robot-corral/mazebot/README.md

# mazebot
robot which sole purpose is to escape a maze
