robot-corral/mazebot/docs/deterministic-os.pdf

## High level design

Design is for single core MCU (at least for now).

Main | SVCall | Scheduler Timer Start

Initialize hardware

Initialize OS
Start first task / SVCall 0
Select next task to run Run task 0 | Scheduler Timer Interrupt | Select next task to run Run task 1 | Task 1 finished / SVCall 0

Select next task to run Continue running task 0

Select next task to run

... Code executing with main stack

Code executing with task 0 process stack Code executing with task 1 process stack
Figure 1 Task execution flow

### Task storage

To avoid copying a lot of data in case maximum number of tasks is largish, we are going to store tasks in a pre-allocated list. See Figure 2. List is stored with highest priority tasks 1st. Each node has index link to the next node. Index of the root of the list is going to be stored in a global variable.
We also going to store index of the currently running node and its parent. This helps us to avoid navigating the list when we want to either delete task which finished execution or move task to the back of its priority group if it was suspended.
The only loop which remains during task switching is when we need to move suspended task to the end of the group of tasks which have the same priority (not sure if it’s worth removing it, need to check how many long running tasks with the same priority am I going to have).

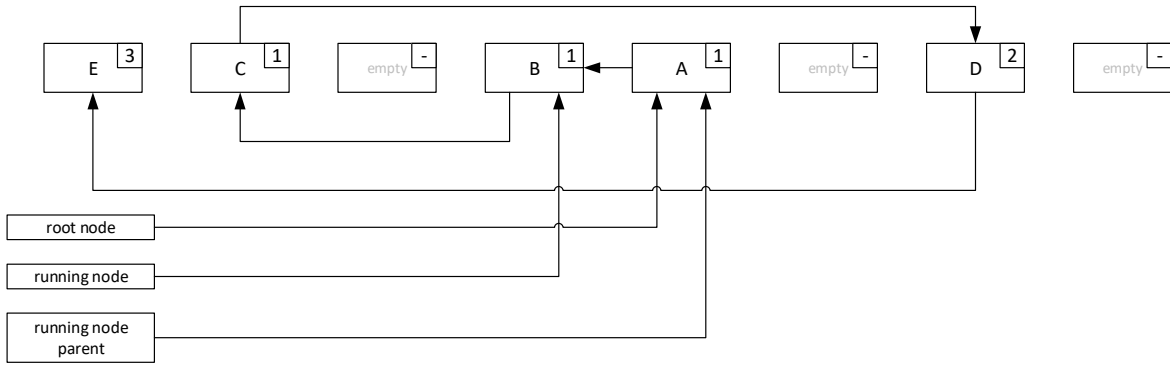
[picture p20: figure]
empty; root node; running node parent; running node

Figure 2 Task static allocation storage design
When task with the same priority we always add it to the end of the group of tasks which have the same priority. This way we maintain relative order among tasks with the same priority and task which was added first will be executed first. See Figure 3. We are adding task F which goes after task C which was the last one in the group of tasks with priority 1.
In all figures we use red color to depict what nodes and links were changed by the operation which was performed.

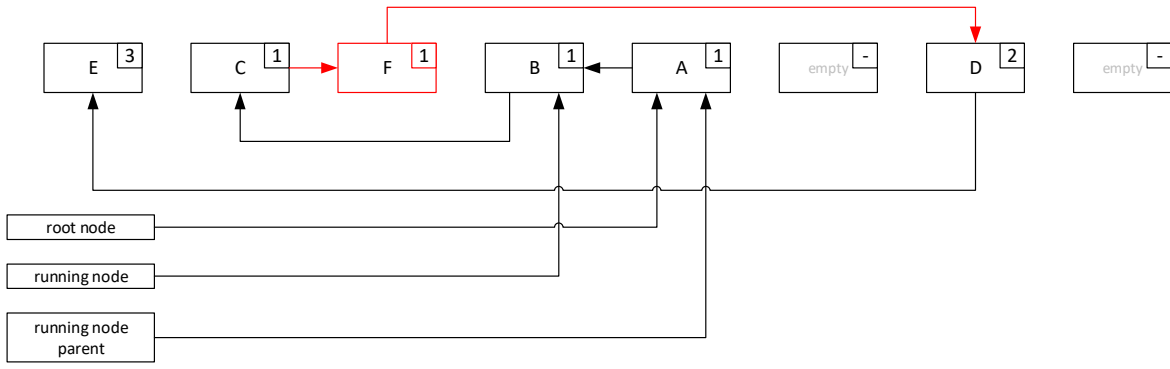
[picture p21: figure]
empty; root node; running node parent; running node

Figure 3 Adding task with the same priority as currently running task
When we add task with priority higher than currently running task, this task will go before currently running task (but after all other tasks which have higher priority). In this case we add task F with priority
0. See Figure 4.

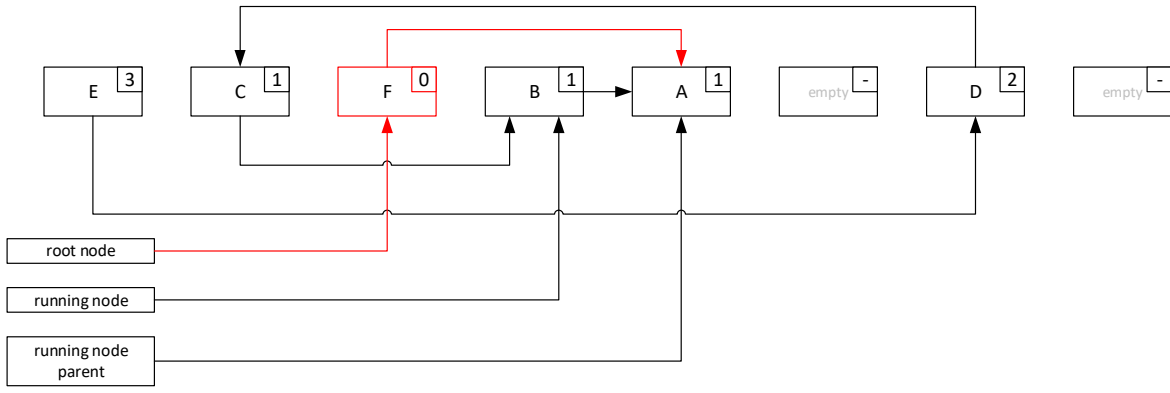
[picture p22: figure]
empty; root node; running node parent; running node

Figure 4 Adding task with highest priority
When we add task with priority lower than the current running task it will go behind it in the list. In case of the task with the lowest priority it will go to the very end of the list. In this case we add task F with priority 4. See Figure 5.

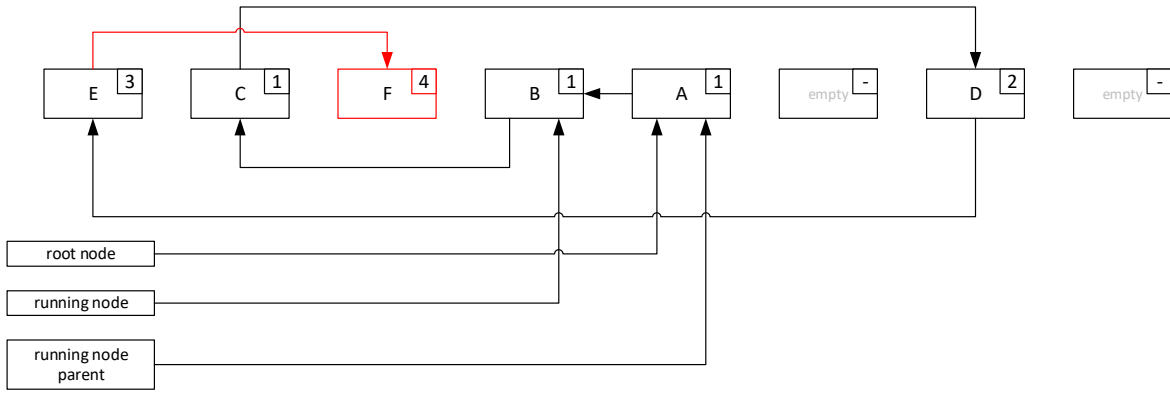
[picture p23: figure]
empty; root node; running node parent; running node

Figure 5 Adding task with lowest priority
When we need to pick next task to execute on scheduler timer call, we pick tasks with highest available priority. If currently running task has highest priority, we continue running it. If not, we suspend current task, and move it to the end of the group of tasks with the same priority (if there is more than one task with the same priority). This is done so all tasks with the same priority will execute in “parallel”. Each time slice will execute different tasks in the order they came in. For instance, if we have tasks B-A-C with priority 1 (first task in the list is the task which is being executed), then on next time slice it will be A-C-B, next one after that will be C-B-A, then B-A-C, and so on. See Figure 6.

empty

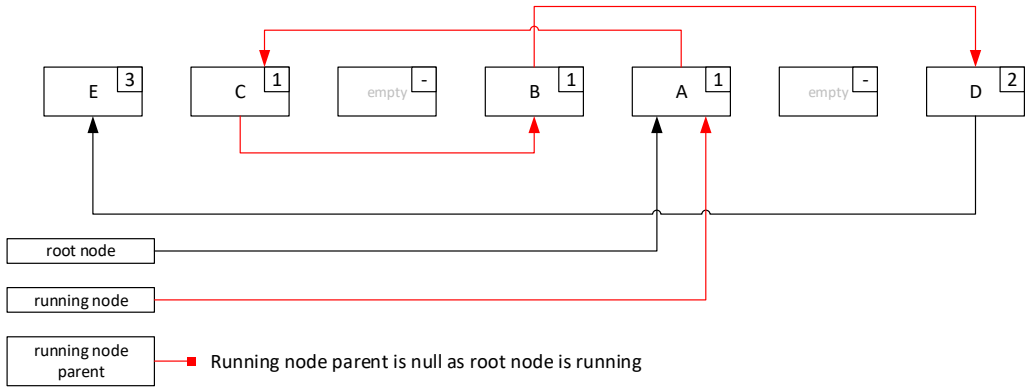
[picture p24: figure]
empty; root node; running node parent; running node

- | - | - Running node parent is null as root node is running

Figure 6 Task B was suspended, and task A was resumed

## Arm implementation details

Arm supports context switching on hardware level. There are 2 features which allow this:
- Supervisor call (SVCall) and deferred supervisor call (PendSV) interrupts
- SP_main and SP_process stacks
SVCall and PendSV allow us to avoid critical sections when doing context switching. If you have the same priority for SVCall, PendSV, and scheduling timer interrupts, then all system calls do not need any synchronization.
OS will have to issue SVCall:
- to start running task
- after task finished execution
- when we want to switch tasks on regular basis using scheduler timer
To understand how to achieve this we need to talk about ARM interrupts, stacks and registers.

### Registers

32-bit ARM processors have 16 registers:
R0 | | General / C function arguments / result values | Caller saved
R1 | | General / C function arguments / result values | Caller saved
R2 | | General / C function arguments / result values | Caller saved
R3 | | General / C function arguments / result values | Caller saved
R4 | | General | Callee saved
R5 | | General | Callee saved
R6 | | General | Callee saved
R7 | | General | Callee saved
R8 | | General | Callee saved
R9 | | General | Callee saved
R10 | | General | Callee saved
R11 | | General | Callee saved
R12 | | General | Caller saved
R13 | SP | Stack pointer | Callee saved
R14 | LR | Link register (return address) / General | Caller saved
R15 | PC | Program counter | N/A
Table 1 32-bit ARM registers
From context point of view there are 2 important groups of registers:
- caller saved – if you are going to call a function and you use any of the “caller saved” registers it is your responsibility to save them. If you do not the function you are calling is free to change their values.
- callee saved – before modifying these registers in your function you have to store their original values and restore them before you return from your function. Failure to do so can result in an undefined behavior.

### Stacks

ARM has 2 stacks MSP (SP_main) and PSP (SP_process). By default, when processor resets it uses MSP stack. When interrupt is generated interrupt handler code will also use MSP stack (even if code which was running before interrupt was using PSP stack).
You can choose which stack your code is using by changing CONTROL.SPSEL bit. Here is a sample code which sets SPSEL to 1.

# load CONTROL register to R3

MRS | R3, CONTROL
# set bit 1 (SPSEL = 1, this will make sure we use process stack instead of main stack)

ORR | R3, 0x02
# write R3 register value into CONTROL register

MSR | CONTROL, R3

To change PSP or MSP stack address you can simply modify those registers. Here is a sample code which sets PSP address to address store in R0 register

# write R0 which has process stack start address to SP (stack register)

MSR | PSP, R0

If you want to change current stack address you can simply modify SP register as you do with any other register. Here is a sample code which allocates 12 bytes on a current stack

# allocate 12 bytes on current stack

SUB | SP, 12

### Interrupts

When interrupt is generated ARM stores all caller saved registers on a stack which was active in the code which was running prior to interrupt. After that ARM sets MSP as a main stack. So, by default, all interrupt handlers will execute with MSP as their stack regardless of which stack was used prior interrupt request.

data 3
data 2
data 1
data 0

pdata 2
pdata 1
pdata 0
SP_process | SP_main

0x1000 0000

0x0FFF FFFC

0x0FFF FFF8

0x0FFF FFF4

0x1200 0000

0x11FF FFFC

0x11FF FFF8

0x00

-0x04

-0x08

-0x0C

0x00

-0x04

-0x08

active stack

Figure 7 Main and Process stacks before interrupt

pdata 2
pdata 1
pdata 0

SP_process

0x11FF FFE0

0x11FF FFDC

0x11FF FFD8

0x00

-0x04

-0x08

R0
R1
R2
R3
R12
LR
Return Address
xPSR

0x1200 0000

0x11FF FFFC

0x11FF FFF8

0x11FF FFE4

0x11FF FFF0

0x11FF FFEC

0x11FF FFE8

0x11FF FFF4 | -0x0C -0x10

-0x14

-0x18

-0x1C

-0x20

-0x24

-0x28 | data 3
data 2
data 1
data 0

SP_main

0x1000 0000

0x0FFF FFFC

0x0FFF FFF8

0x0FFF FFF4

0x00

-0x04

-0x08

-0x0C

active stack

Figure 8 Main and Process stacks after interrupt occurred but prior entering interrupt handler
If code which was executing prior exception had stack which wasn’t 8-byte aligned interrupt handler will insert dummy value before storing any registers on the stack.

### Context Switching

Given all the information about registers, stacks, and interrupts we can now describe how context switching works.
When we generate SVCall 0 at the start of OS or when current task finished executing or when scheduler timer interrupt handler is called, we have to do the following:
1) select next task which will be running (if no task found we can run dummy idle task)
2) If there was a task running before we selected next task, we need to save old task’s “callee saved” registers (R4, R5, R6, R7, R8, R9, R10, R11, PSP).
3) next task has never executed before

SP_process
new task

0x00

-0x04

-0x08

R0
R1
R2
R3
R12
LR
Return Address
0x1300 0000 | xPSR

0x12FF FFFC

0x12FF FFF8

0x12FF FFE4

0x12FF FFF0

0x12FF FFEC

0x12FF FFE8

0x12FF FFF4 | -0x0C -0x10

-0x14

-0x18

-0x1C

SP_process
idle

0x00

-0x04

-0x08

R0
R1
R2
R3
R12
LR
Return Address
0x1200 0000 | xPSR

0x11FF FFFC

0x11FF FFF8

0x11FF FFE4

0x11FF FFF0

0x11FF FFEC

0x11FF FFE8

0x11FF FFF4 | -0x0C -0x10

-0x14

-0x18

-0x1C

copy
value

store task function start address store SVC 0 instruction address store task parameter value

Figure 9 Fixing process stack for the new task (in this case old stack is from idle task but it will be similar if other task was executing before)
a. allocate space on task specific process stack for caller saved registers (8 x 4 bytes = 32 bytes)
b. set PSP to point to new task specific process stack (in Figure 9 it’s 0x12FF FFE4, processor will unwind stack and restore respective registers during interrupt exit procedure).

c. Set xPSR register value to its reset value. See “B1.5.5 Reset behavior” in ARMv7-M Architecture Reference Manual.
d. save task parameter to the top of the stack (this is where register R0 is stored)
e. save address of SVC 0 instruction on the stack where LR register is located (in our case 0x12FF FFF8). This will ensure that after task function completes it will request OS to schedule next task
f. save task function start address on the stack where Return Address is located (in our case 0x12FF FFFC). This will ensure that task function will start executing immediately after we exit from interrupt handler
4) next task was previously suspended
a. restore next task’s “callee saved registers (R4, R5, R6, R7, R8, R9, R10, R11, PSP). R0-R3, R12, LR, Return Address and xPSR are stored on the process stack and as we change PSP to point to process stack exception handler exit mechanism will restore those registers for us.
5) return from interrupt handler

### Timed task scheduler

To switch tasks, we need to call task scheduler periodically from the timer. We have two options to do this:
1. We can implement timer interrupt ourselves. This way we ensure that handler doesn’t change register values set for the task which will continue execution after we are done with the timer call. Need to investigate what will happen if timer was about to return not to process but to another lower priority interrupt.
2. We can use PendSV interrupt using the code below. PendSV is a differed interrupt which will be triggered only when execution returns from timer interrupt to the process.

“SCB->ICSR |= SCB_ICSR_PENDSVSET_Msk;”

For more information see “Use of SVCall and PendSV to avoid critical code regions” in ARMv7-M Architecture Reference Manual.
Overall option two seems to be a safer bet.
