robot-corral/mazebot/(threads)

Thread 19 (2020-01-13):

test board next to BLE wireless board. Need to check interference from BLE and if I need to put capacitors.

usaguerrilla, 2020-01-13:

usaguerrilla, 2020-01-19:
board seems to be working jut fine
need to move to use LL API instead of HAL

Closed 2020-01-19.

Thread 20 (2020-01-18):

investigate why first 2-4 communications lead to errors (client calling line sensor)

usaguerrilla, 2020-01-18:

Thread 22 (2020-01-18):

adc hardware should be reset on failure which might be related to hardware (dma, etc.)

usaguerrilla, 2020-01-18:

Thread 24 (2020-01-20):

what to do in case of error and one tx or rx completed flag gets reset and another one doesn't

usaguerrilla, 2020-01-20:

Thread 41 (2020-02-02):

position controller calibration is flaky

usaguerrilla, 2020-02-02:
should be:

1) move until 0 limiter is on
2) move right and reset position to 0 if 0 limiter fires
3) move until max limiter is on
4) move left and remember max position where max limiter fired as MAX_POSITION.
5) use (MAX_POSITION - safety) as position controller range

Closed 2020-02-03.

Thread 42 (2020-02-02):

fix potential concurrency issues in position controller (timer and limit switches have different interrupt priorities)

usaguerrilla, 2020-02-02:

Closed 2020-02-03.

Thread 44 (2020-03-03):

add command to reset wireless line sensor

usaguerrilla, 2020-03-03:

Thread 45 (2020-03-03):

add command to reset line sensor

usaguerrilla, 2020-03-03:

Thread 55 (2020-03-10):

add schematics and design pcb

usaguerrilla, 2020-03-10:
- mcu (powerful, maybe even multicore)
- imu
- left/right motor control connections
- left/right motor encoders connections
- line sensor connection
- voltage regulator
- led (good for debugging)
- mini sd card
- pins to connect logic analyzer / oscilloscope
- reset button
- start / pause button
- flush sd button
- ok / error led
- sd busy led
- st-link
- spi / uart for inter-processor communication

Thread 56 (2020-03-10):

need to minimize time between disableInterrupts / setInterruptMask

usaguerrilla, 2020-03-10:
currently too much time is spent while interrupts are disabled.
need to only disable them while updating status, changing hardware state.

Closed 2020-03-15.

Thread 61 (2020-03-13):

position controller has small error on each move

usaguerrilla, 2020-03-13:
if I move 9468 steps in one go position controller moves 118.35 mm.

If I move 9480 steps controller moves around 3 mm more than it should.

usaguerrilla, 2020-03-14:
- had a short spike on motor movement start
- disabled motor too fast at the end without allowing it to move

Closed 2020-03-14.

Thread 62 (2020-03-14):

improve timers usage

usaguerrilla, 2020-03-14:
- dma should only be used to enable slow down if we don't have constant speed movement
- timer should be used in all other cases to speed up, move at constant speed, and stat slowdown after constant speed

usaguerrilla, 2020-03-15:
not needed

usaguerrilla, 2020-03-17:
not needed again

Closed 2020-03-17.
