robot-corral/mazebot/hardware/line-sensor/line-sensor-var1a-r3.brd

## EAGLE design hardware/line-sensor/line-sensor-var1a-r3.brd (2020-03-11)

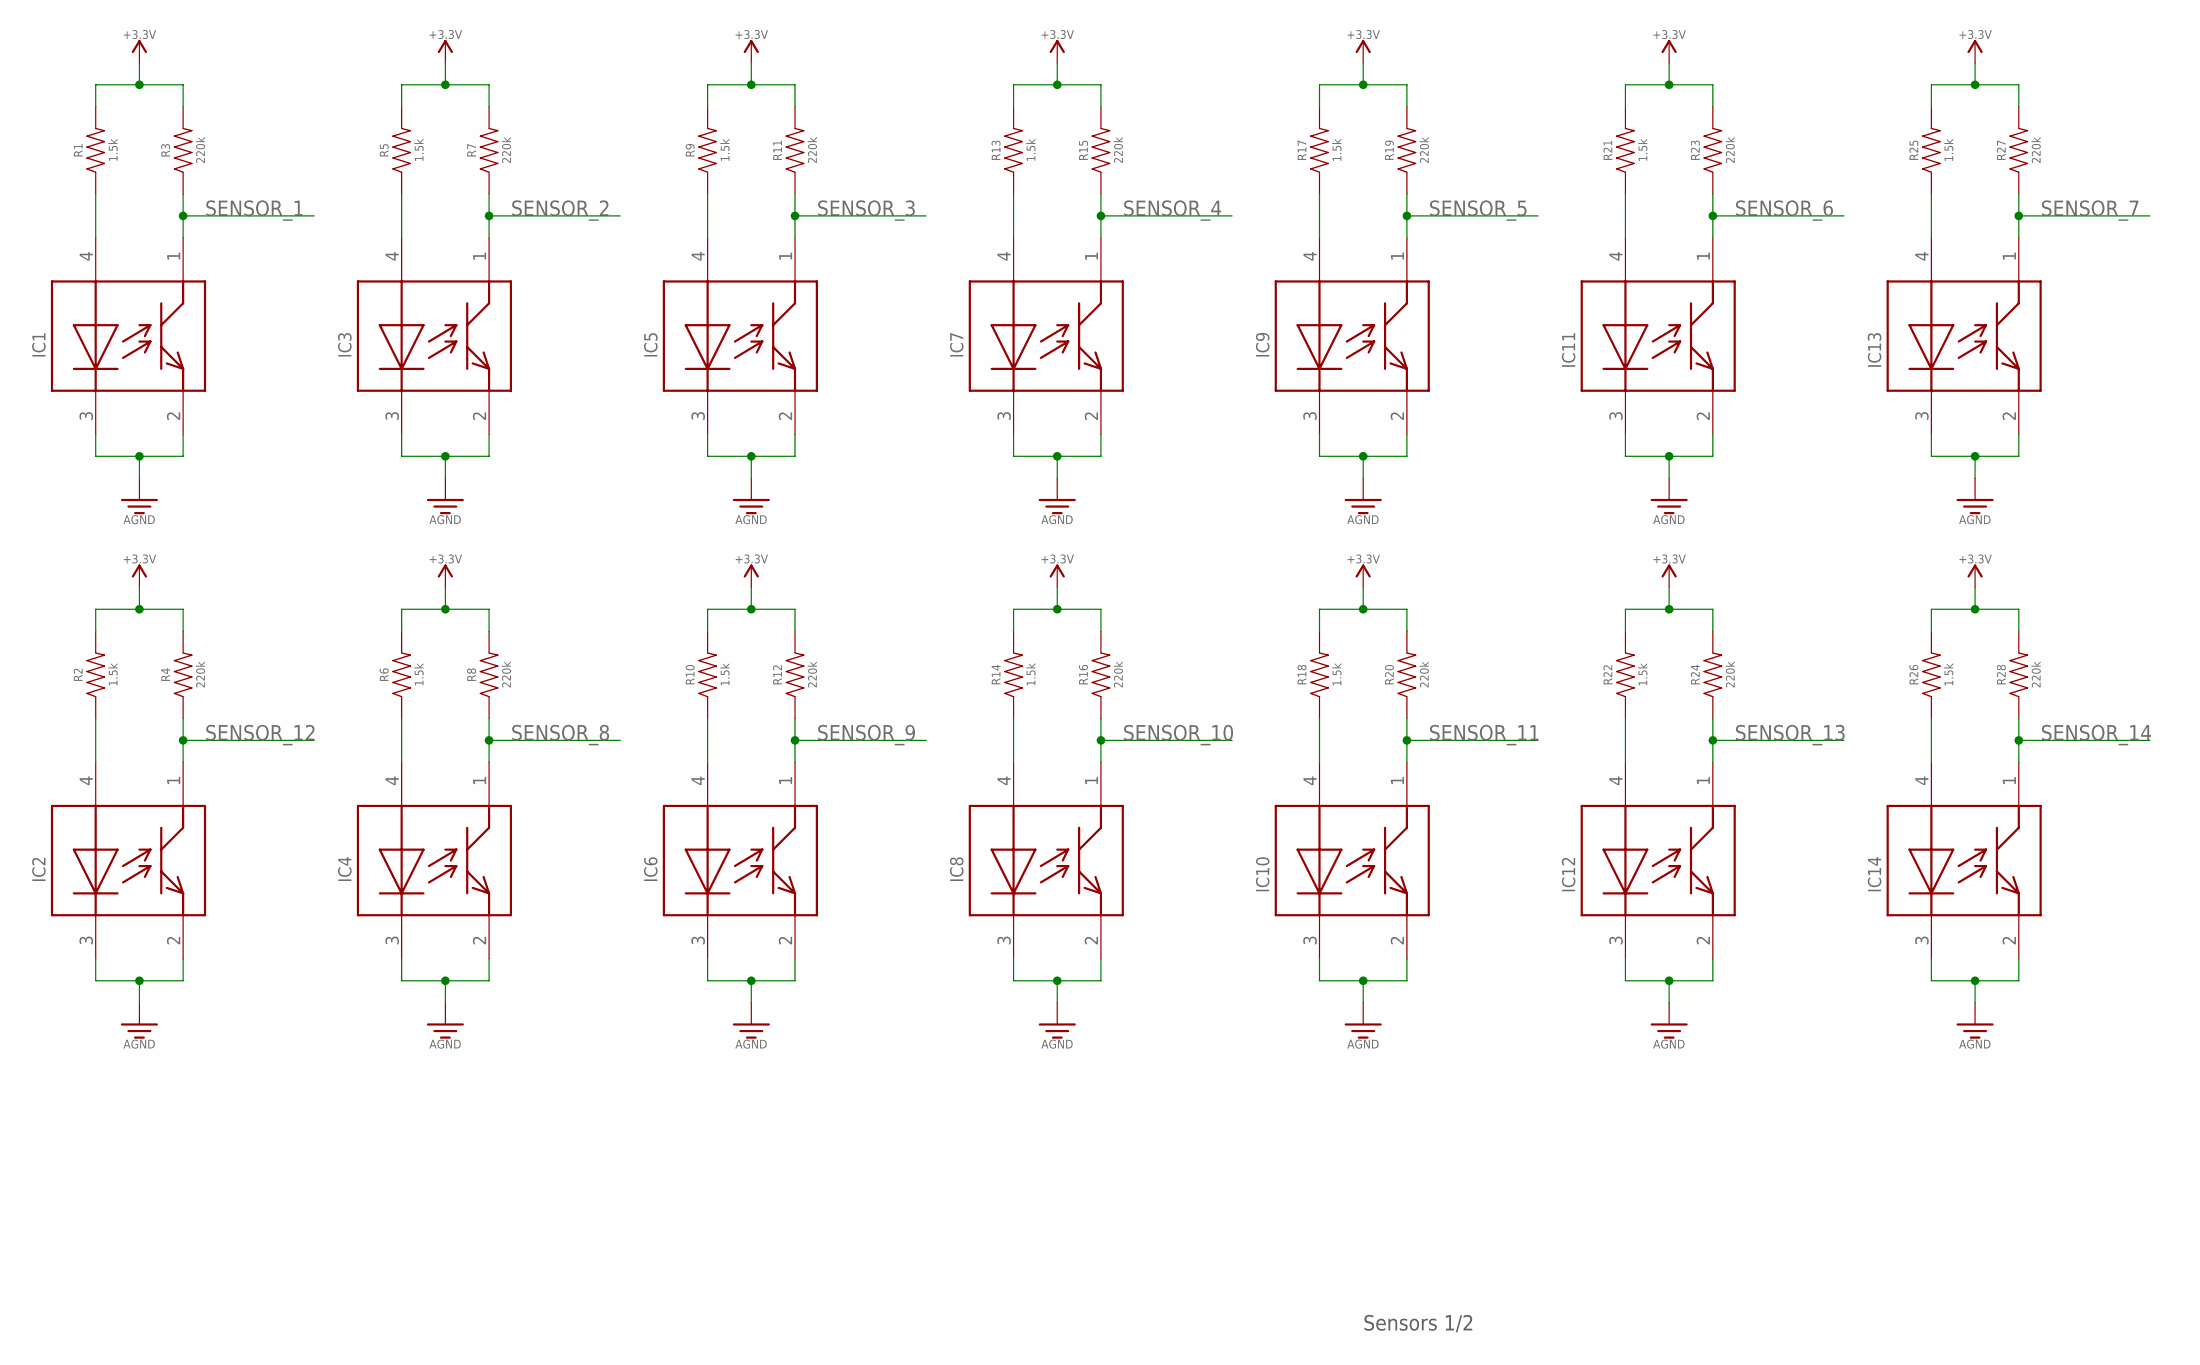
[picture p25: schematic line-sensor-var1a-r3.sch, sheet 1]

Parts:
IC1, IC2, IC3, IC4, IC5, IC6, IC7, IC8, IC9, IC10, IC11, IC12, IC13, IC14: GP2S60
R1, R2, R5, R6, R9, R10, R13, R14, R17, R18, R21, R22, R25, R26: 1.5k; RESISTOR-0603
R3, R4, R7, R8, R11, R12, R15, R16, R19, R20, R23, R24, R27, R28: 220k; RESISTOR-0603

Connections:
GND: IC1.2, IC1.3, IC2.2, IC2.3, IC3.2, IC3.3, IC4.2, IC4.3, IC5.2, IC5.3, IC6.2, IC6.3, IC7.2, IC7.3, IC8.2, IC8.3, IC9.2, IC9.3, IC10.2, IC10.3, IC11.2, IC11.3, IC12.2, IC12.3, IC13.2, IC13.3, IC14.2, IC14.3; also elsewhere on the board
unnamed: IC3.4, R5.P$1 (1)
unnamed: IC1.4, R1.P$1 (1)
unnamed: IC5.4, R9.P$1 (1)
unnamed: IC7.4, R13.P$1 (1)
unnamed: IC9.4, R17.P$1 (1)
unnamed: IC11.4, R21.P$1 (1)
unnamed: IC13.4, R25.P$1 (1)
unnamed: IC4.4, R6.P$1 (1)
unnamed: IC6.4, R10.P$1 (1)
unnamed: IC8.4, R14.P$1 (1)
unnamed: IC10.4, R18.P$1 (1)
unnamed: IC2.4, R2.P$1 (1)
unnamed: IC12.4, R22.P$1 (1)
unnamed: IC14.4, R26.P$1 (1)
SENSOR_1: IC1.1, R3.P$1 (1); also elsewhere on the board
SENSOR_2: IC3.1, R7.P$1 (1); also elsewhere on the board
SENSOR_3: IC5.1, R11.P$1 (1); also elsewhere on the board
SENSOR_4: IC7.1, R15.P$1 (1); also elsewhere on the board
SENSOR_5: IC9.1, R19.P$1 (1); also elsewhere on the board
SENSOR_6: IC11.1, R23.P$1 (1); also elsewhere on the board
SENSOR_7: IC13.1, R27.P$1 (1); also elsewhere on the board
SENSOR_8: IC4.1, R8.P$1 (1); also elsewhere on the board
SENSOR_9: IC6.1, R12.P$1 (1); also elsewhere on the board
SENSOR_10: IC8.1, R16.P$1 (1); also elsewhere on the board
SENSOR_11: IC10.1, R20.P$1 (1); also elsewhere on the board
SENSOR_12: IC2.1, R4.P$1 (1); also elsewhere on the board
SENSOR_13: IC12.1, R24.P$1 (1); also elsewhere on the board
SENSOR_14: IC14.1, R28.P$1 (1); also elsewhere on the board
VDD: R1.P$2 (2), R2.P$2 (2), R3.P$2 (2), R4.P$2 (2), R5.P$2 (2), R6.P$2 (2), R7.P$2 (2), R8.P$2 (2), R9.P$2 (2), R10.P$2 (2), R11.P$2 (2), R12.P$2 (2), R13.P$2 (2), R14.P$2 (2), R15.P$2 (2), R16.P$2 (2), R17.P$2 (2), R18.P$2 (2), R19.P$2 (2), R20.P$2 (2), R21.P$2 (2), R22.P$2 (2), R23.P$2 (2), R24.P$2 (2), R25.P$2 (2), R26.P$2 (2), R27.P$2 (2), R28.P$2 (2); also elsewhere on the board

Notes on the sheet:
Sensors 1/2

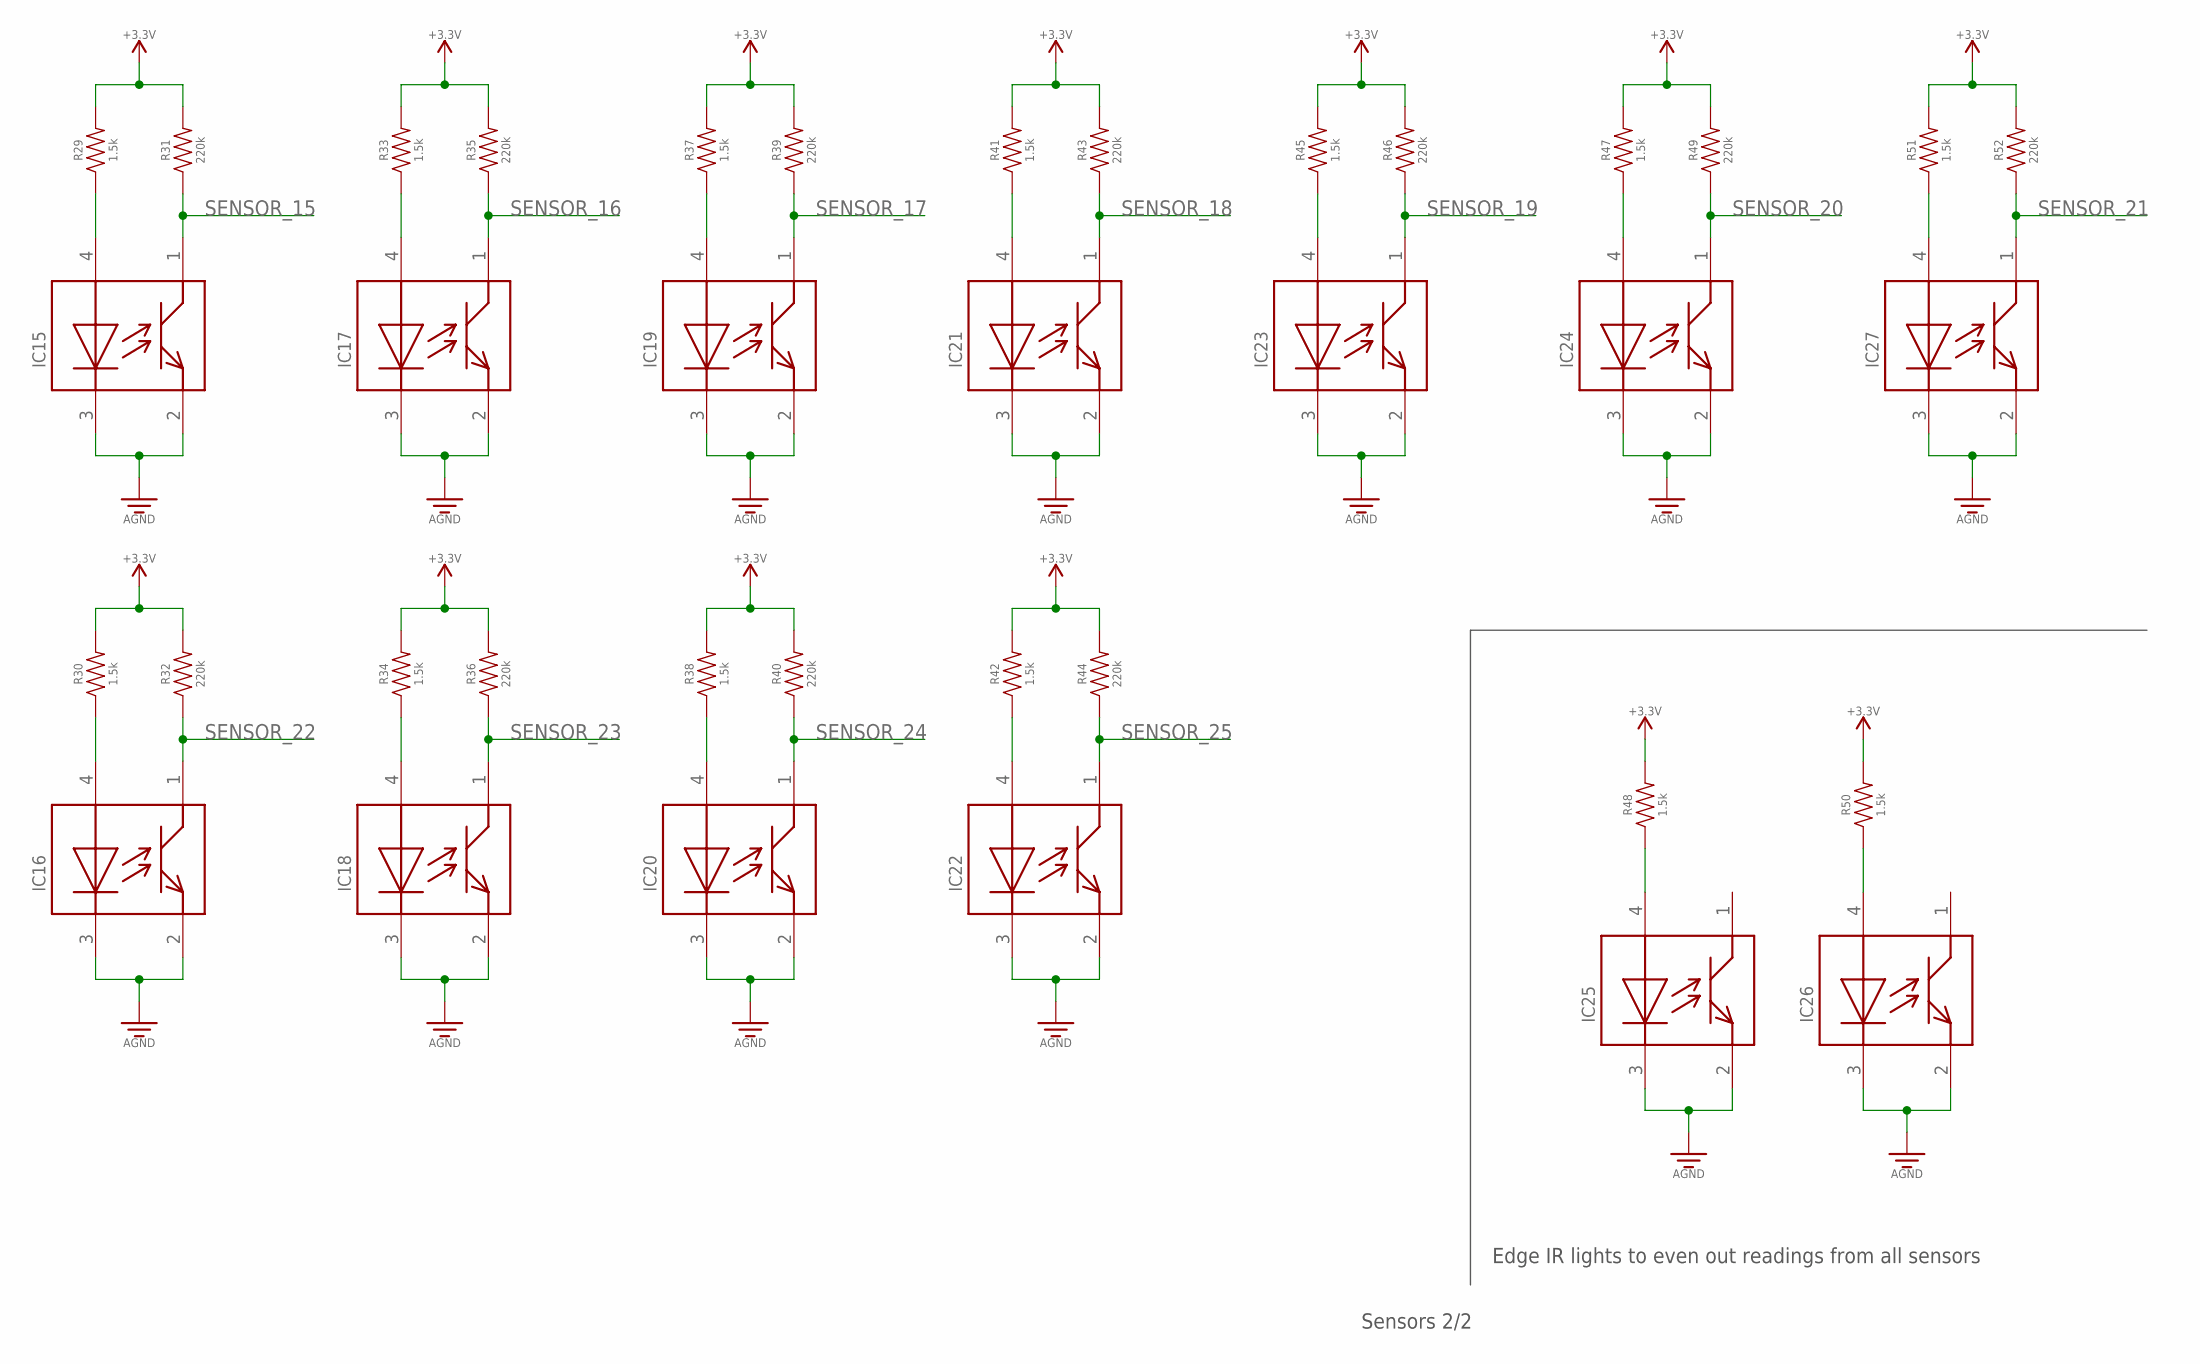
[picture p26: schematic line-sensor-var1a-r3.sch, sheet 2]

Parts:
IC15, IC16, IC17, IC18, IC19, IC20, IC21, IC22, IC23, IC24, IC25, IC26, IC27: GP2S60
R29, R30, R33, R34, R37, R38, R41, R42, R45, R47, R48, R50, R51: 1.5k; RESISTOR-0603
R31, R32, R35, R36, R39, R40, R43, R44, R46, R49, R52: 220k; RESISTOR-0603

Connections:
GND: IC15.2, IC15.3, IC16.2, IC16.3, IC17.2, IC17.3, IC18.2, IC18.3, IC19.2, IC19.3, IC20.2, IC20.3, IC21.2, IC21.3, IC22.2, IC22.3, IC23.2, IC23.3, IC24.2, IC24.3, IC25.2, IC25.3, IC26.2, IC26.3, IC27.2, IC27.3; also elsewhere on the board
unnamed: IC15.4, R29.P$1 (1)
unnamed: IC17.4, R33.P$1 (1)
unnamed: IC19.4, R37.P$1 (1)
unnamed: IC21.4, R41.P$1 (1)
unnamed: IC23.4, R45.P$1 (1)
unnamed: IC24.4, R47.P$1 (1)
unnamed: IC27.4, R51.P$1 (1)
unnamed: IC16.4, R30.P$1 (1)
unnamed: IC18.4, R34.P$1 (1)
unnamed: IC20.4, R38.P$1 (1)
unnamed: IC22.4, R42.P$1 (1)
unnamed: IC26.4, R50.P$1 (1)
unnamed: IC25.4, R48.P$1 (1)
SENSOR_15: IC15.1, R31.P$1 (1); also elsewhere on the board
SENSOR_16: IC17.1, R35.P$1 (1); also elsewhere on the board
SENSOR_17: IC19.1, R39.P$1 (1); also elsewhere on the board
SENSOR_18: IC21.1, R43.P$1 (1); also elsewhere on the board
SENSOR_19: IC23.1, R46.P$1 (1); also elsewhere on the board
SENSOR_20: IC24.1, R49.P$1 (1); also elsewhere on the board
SENSOR_21: IC27.1, R52.P$1 (1); also elsewhere on the board
SENSOR_22: IC16.1, R32.P$1 (1); also elsewhere on the board
SENSOR_23: IC18.1, R36.P$1 (1); also elsewhere on the board
SENSOR_24: IC20.1, R40.P$1 (1); also elsewhere on the board
SENSOR_25: IC22.1, R44.P$1 (1); also elsewhere on the board
VDD: R29.P$2 (2), R30.P$2 (2), R31.P$2 (2), R32.P$2 (2), R33.P$2 (2), R34.P$2 (2), R35.P$2 (2), R36.P$2 (2), R37.P$2 (2), R38.P$2 (2), R39.P$2 (2), R40.P$2 (2), R41.P$2 (2), R42.P$2 (2), R43.P$2 (2), R44.P$2 (2), R45.P$2 (2), R46.P$2 (2), R47.P$2 (2), R48.P$2 (2), R49.P$2 (2), R50.P$2 (2), R51.P$2 (2), R52.P$2 (2); also elsewhere on the board

Notes on the sheet:
Sensors 2/2
Edge IR lights to even out readings from all sensors

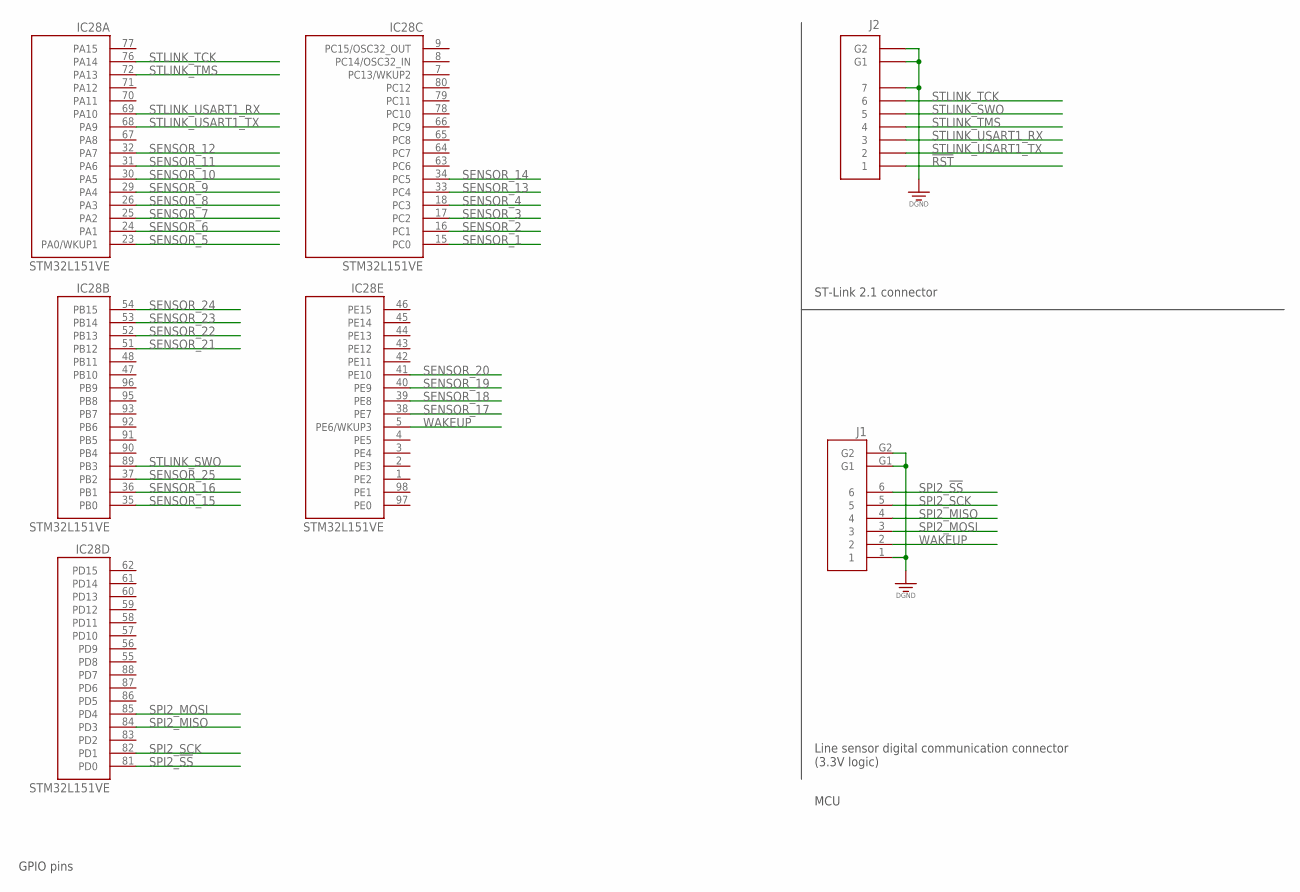
[picture p27: schematic line-sensor-var1a-r3.sch, sheet 3]

Parts:
IC28: STM32L151VE; LQFP100_14X14
J1: MOLEX-502382-06XX
J2: MOLEX-53261-0771

Connections:
!RST: J2.1; also elsewhere on the board
GND: J1.1, J1.G1, J1.G2, J2.7, J2.G1, J2.G2; also elsewhere on the board
SENSOR_1: IC28.15 (PC0); also elsewhere on the board
SENSOR_2: IC28.16 (PC1); also elsewhere on the board
SENSOR_3: IC28.17 (PC2); also elsewhere on the board
SENSOR_4: IC28.18 (PC3); also elsewhere on the board
SENSOR_5: IC28.23 (PA0/WKUP1); also elsewhere on the board
SENSOR_6: IC28.24 (PA1); also elsewhere on the board
SENSOR_7: IC28.25 (PA2); also elsewhere on the board
SENSOR_8: IC28.26 (PA3); also elsewhere on the board
SENSOR_9: IC28.29 (PA4); also elsewhere on the board
SENSOR_10: IC28.30 (PA5); also elsewhere on the board
SENSOR_11: IC28.31 (PA6); also elsewhere on the board
SENSOR_12: IC28.32 (PA7); also elsewhere on the board
SENSOR_13: IC28.33 (PC4); also elsewhere on the board
SENSOR_14: IC28.34 (PC5); also elsewhere on the board
SENSOR_15: IC28.35 (PB0); also elsewhere on the board
SENSOR_16: IC28.36 (PB1); also elsewhere on the board
SENSOR_17: IC28.38 (PE7); also elsewhere on the board
SENSOR_18: IC28.39 (PE8); also elsewhere on the board
SENSOR_19: IC28.40 (PE9); also elsewhere on the board
SENSOR_20: IC28.41 (PE10); also elsewhere on the board
SENSOR_21: IC28.51 (PB12); also elsewhere on the board
SENSOR_22: IC28.52 (PB13); also elsewhere on the board
SENSOR_23: IC28.53 (PB14); also elsewhere on the board
SENSOR_24: IC28.54 (PB15); also elsewhere on the board
SENSOR_25: IC28.37 (PB2); also elsewhere on the board
SPI2_!SS: IC28.81 (PD0), J1.6
SPI2_MISO: IC28.84 (PD3), J1.4
SPI2_MOSI: IC28.85 (PD4), J1.3
SPI2_SCK: IC28.82 (PD1), J1.5
STLINK_SWO: IC28.89 (PB3), J2.5
STLINK_TCK: IC28.76 (PA14), J2.6
STLINK_TMS: IC28.72 (PA13), J2.4
STLINK_USART1_RX: IC28.69 (PA10), J2.3
STLINK_USART1_TX: IC28.68 (PA9), J2.2
WAKEUP: IC28.5 (PE6/WKUP3), J1.2

Notes on the sheet:
MCU
GPIO pins
ST-Link 2.1 connector
Line sensor digital communication connector (3.3V logic)

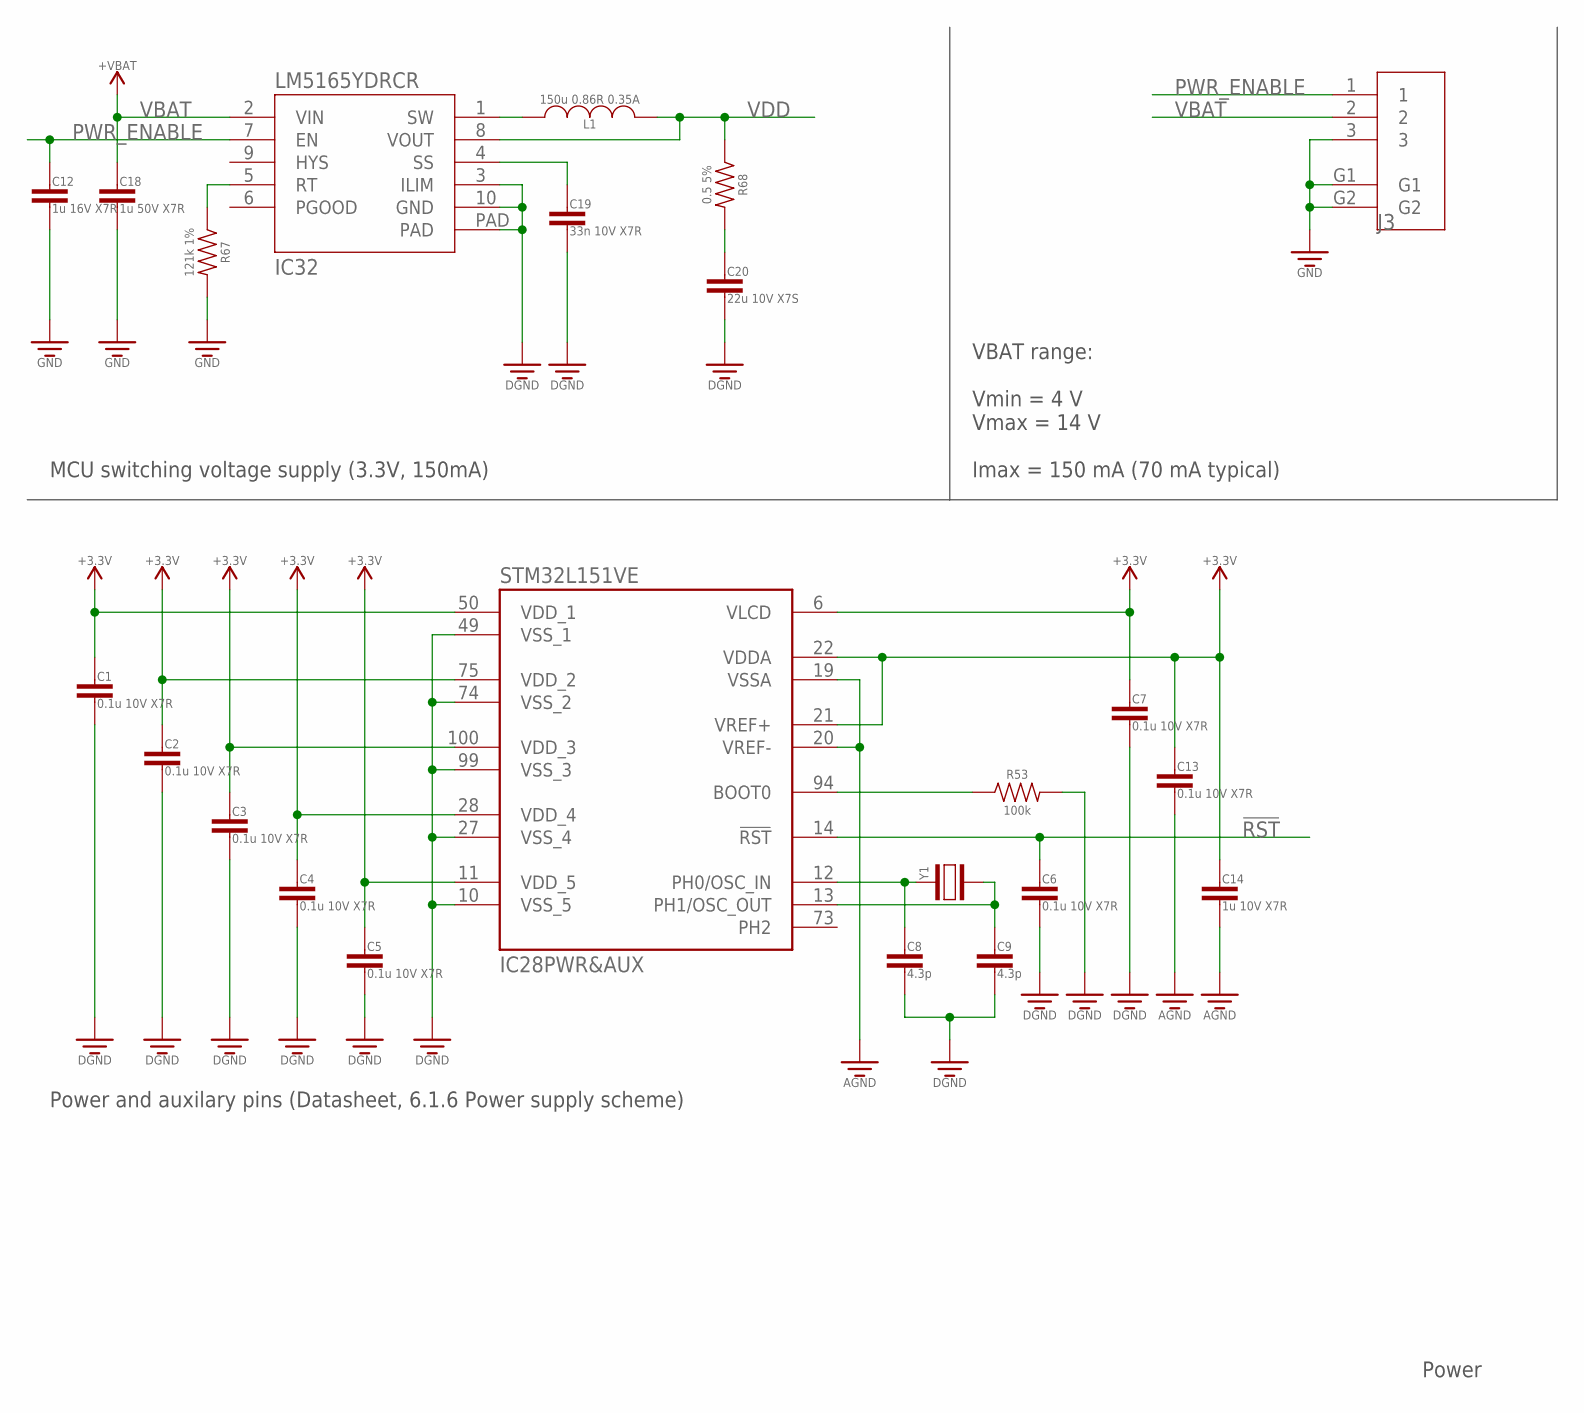
[picture p28: schematic line-sensor-var1a-r3.sch, sheet 4]

Parts:
C1, C2, C3, C4, C5, C6, C7, C13: 0.1u 10V X7R; CAPACITOR-0402
C8, C9: 4.3p; CAPACITOR-0603
C12: 1u 16V X7R; CAPACITOR-0603
C14: 1u 10V X7R; CAPACITOR-0402
C18: 1u 50V X7R; CAPACITOR-1206
C19: 33n 10V X7R; CAPACITOR-0603
C20: 22u 10V X7S; CAPACITOR-0805
IC28: STM32L151VE; LQFP100_14X14
IC32: LM5165YDRCR; VSON-10-0.5MM
J3: MOLEX-502382-03XX
L1: 150u 0.86R 0.35A; PANASONIC-SERIES-H
R53: 100k; RESISTOR-0603
R67: 121k 1%; RESISTOR-0603
R68: 0.5 5%; RESISTOR-0603
Y1: CRYSTALKYOCERA-CX5032GA; KYOCERA-CX5032GA

Connections:
!RST: C6.P$1 (1), IC28.14 (!RST!); also elsewhere on the board
BOOT0: IC28.94 (BOOT0), R53.P$1 (1)
GND: C1.P$2 (2), C2.P$2 (2), C3.P$2 (2), C4.P$2 (2), C5.P$2 (2), C6.P$2 (2), C7.P$2 (2), C8.2, C9.2, C12.2, C13.P$2 (2), C14.P$2 (2), C18.P$2 (2), C19.2, C20.2, IC28.10 (VSS_5), IC28.19 (VSSA), IC28.20 (VREF-), IC28.27 (VSS_4), IC28.49 (VSS_1), IC28.74 (VSS_2), IC28.99 (VSS_3), IC32.3 (ILIM), IC32.10 (GND), IC32.PAD, J3.3, J3.G1, J3.G2, R53.P$2 (2), R67.P$2 (2); also elsewhere on the board
IC32_SW: IC32.1 (SW), L1.1
unnamed: C8.1, IC28.12 (PH0/OSC_IN), Y1.P$1 (1)
unnamed: C9.1, IC28.13 (PH1/OSC_OUT), Y1.P$2 (2)
unnamed: IC32.5 (RT), R67.P$1 (1)
unnamed: C19.1, IC32.4 (SS)
unnamed: C20.1, R68.P$2 (2)
PWR_ENABLE: C12.1, IC32.7 (EN), J3.1
VBAT: C18.P$1 (1), IC32.2 (VIN), J3.2
VDD: C1.P$1 (1), C2.P$1 (1), C3.P$1 (1), C4.P$1 (1), C5.P$1 (1), C7.P$1 (1), C13.P$1 (1), C14.P$1 (1), IC28.6 (VLCD), IC28.11 (VDD_5), IC28.21 (VREF+), IC28.22 (VDDA), IC28.28 (VDD_4), IC28.50 (VDD_1), IC28.75 (VDD_2), IC28.100 (VDD_3), IC32.8 (VOUT), L1.2, R68.P$1 (1); also elsewhere on the board

Notes on the sheet:
Power
VBAT range: Vmin = 4 V Vmax = 14 V Imax = 150 mA (70 mA typical)
MCU switching voltage supply (3.3V, 150mA)
Power and auxilary pins (Datasheet, 6.1.6 Power supply scheme)

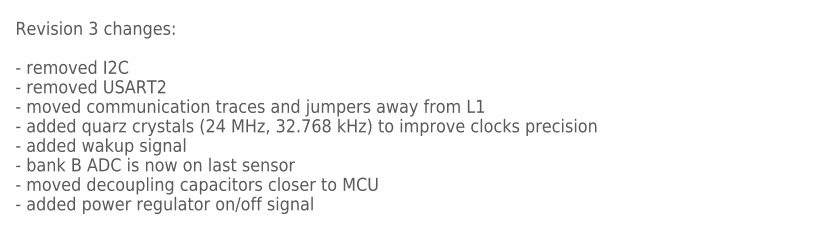
[picture p29: schematic line-sensor-var1a-r3.sch, sheet 5]

Notes on the sheet:
Revision 3 changes: - removed I2C - removed USART2 - moved communication traces and jumpers away from L1 - added quarz crystals (24 MHz, 32.768 kHz) to improve clocks precision - added wakup signal - bank B ADC is now on last sensor - moved decoupling capacitors closer to MCU - added power regulato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

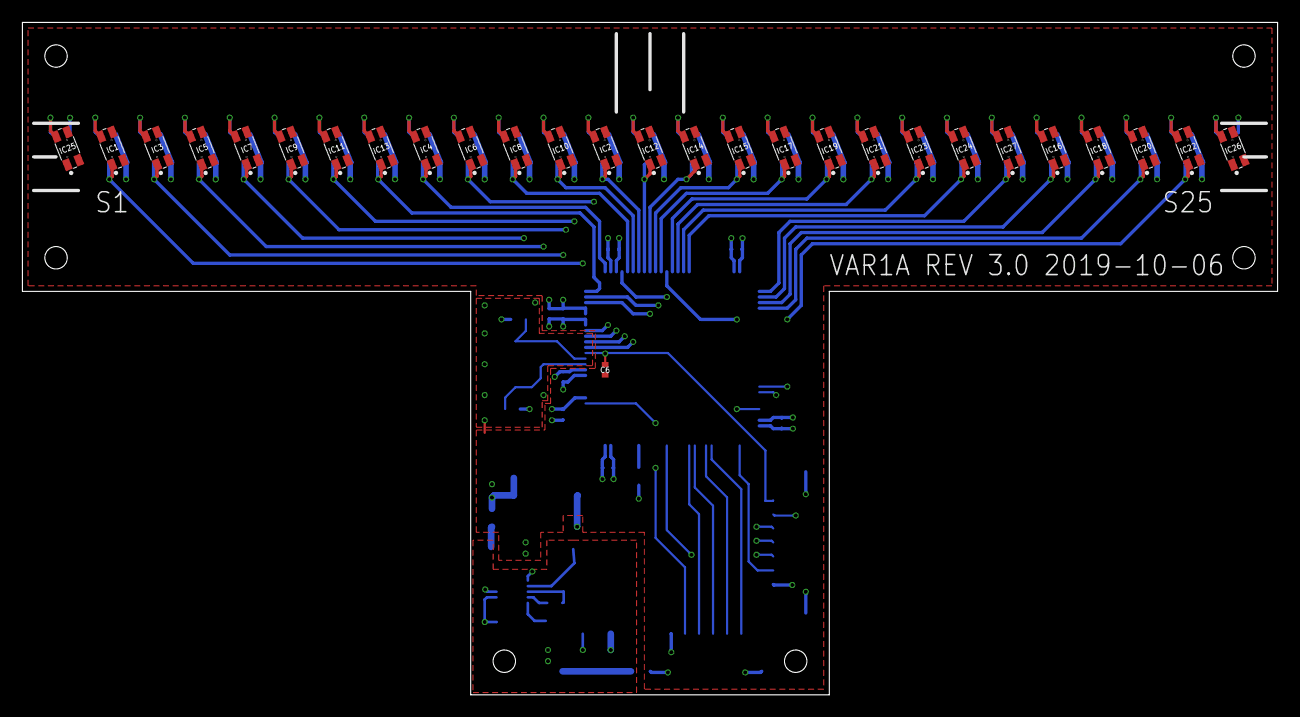
[picture p30: board line-sensor-var1a-r3.brd from above]

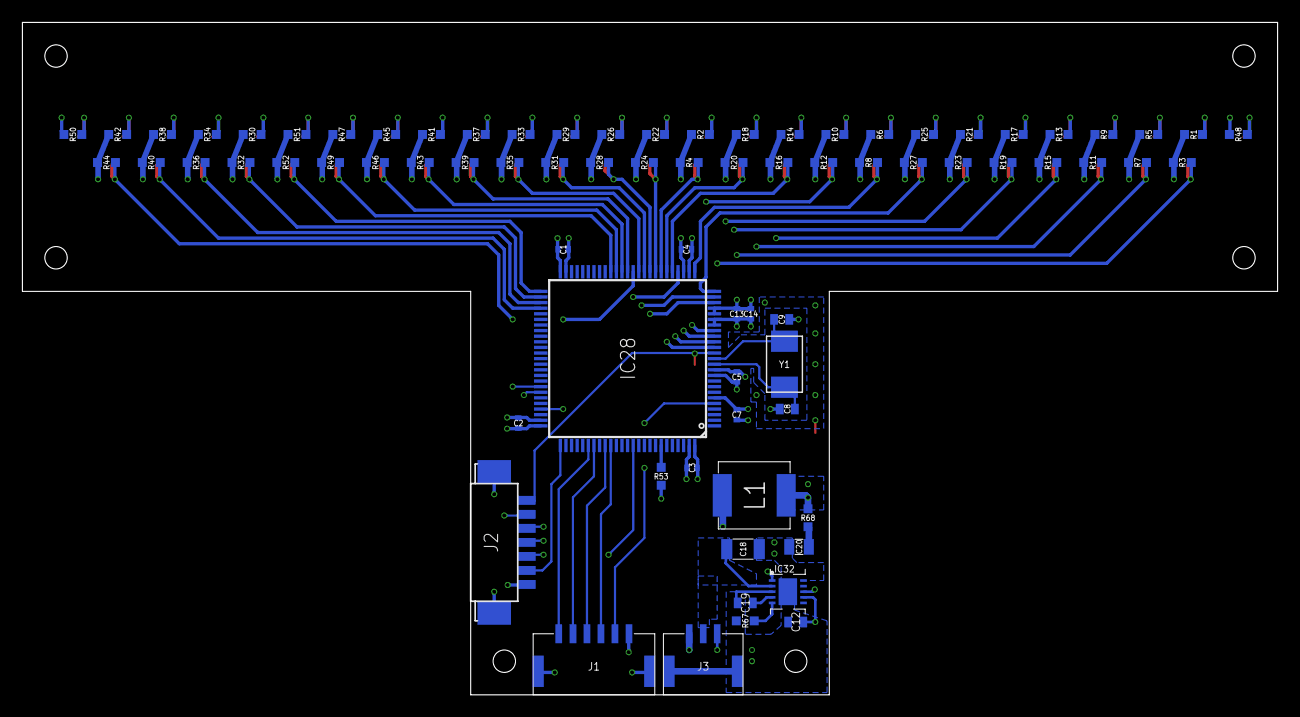
[picture p31: board line-sensor-var1a-r3.brd from below]

Board: 4 copper layers, 112.0 x 60.0 mm, 104 parts (76 on the bottom side), 74 nets.
