robot-corral/mazebot/hardware/line-sensor/line-sensor-r2.brd

## EAGLE design hardware/line-sensor/line-sensor-r2.brd (2019-02-26)

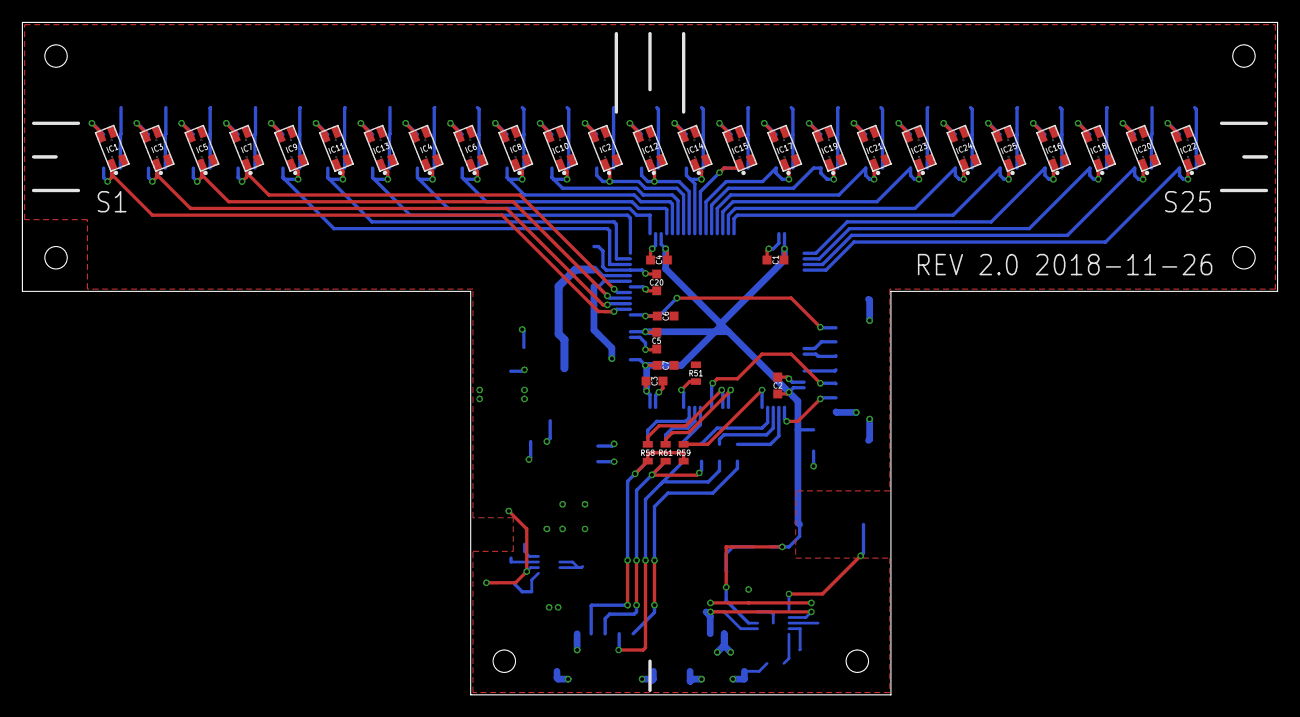
[picture p32: board line-sensor-r2.brd from above]

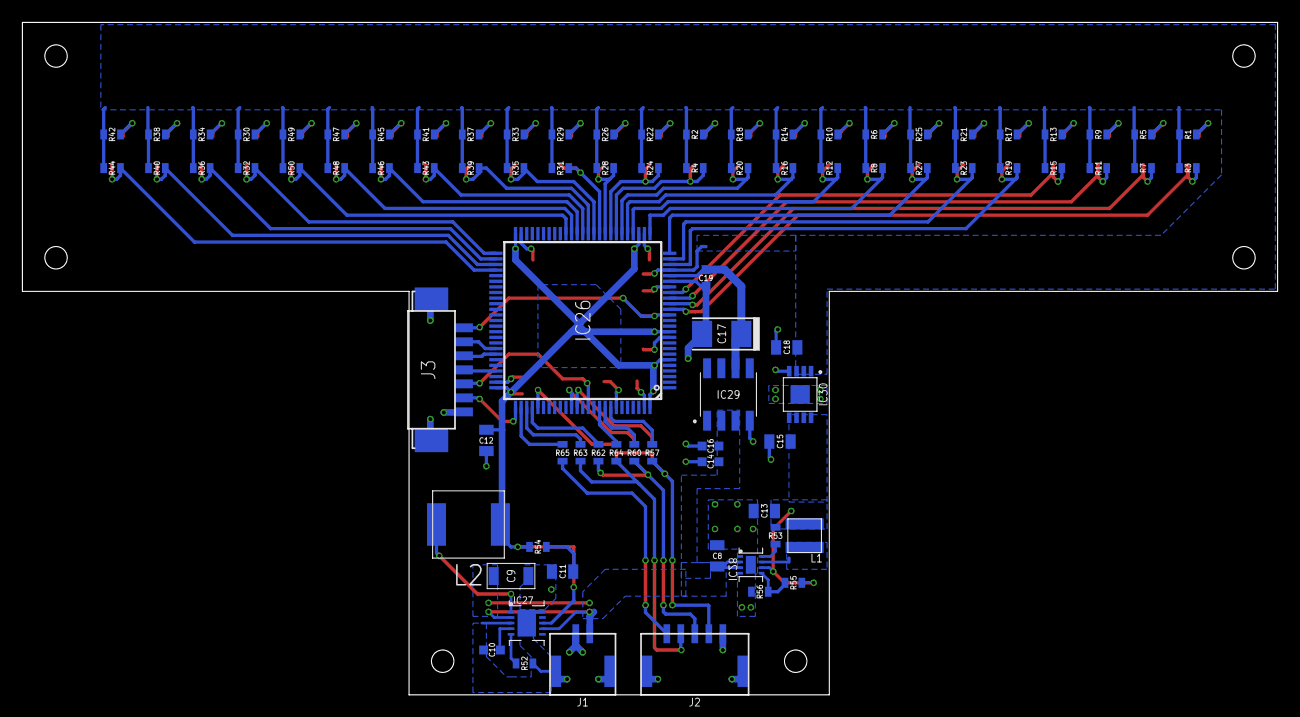
[picture p33: board line-sensor-r2.brd from below]

Board: 2 copper layers, 112.0 x 60.0 mm, 120 parts (83 on the bottom side), 83 nets.

Parts:
C1, C2, C3, C4, C5, C6, C7: 0.1u; CAPACITOR-0603
C8: 10u 50V X7R; CAPACITOR-0805
C9: 1u 50V X7R; CAPACITOR-1206
C10: 33n 10V X7R; CAPACITOR-0603
C11: 22u 10V X7S; CAPACITOR-0805
C12: 4.7u; CAPACITOR-0805
C13: 22u 10V X7R; CAPACITOR-0805
C14: 10u 50V; CAPACITOR-0603
C15, C18: 1u 10V X7R; CAPACITOR-0805
C16: 0.1u 50V; CAPACITOR-0603
C17: 1u 10V Tant; CAPACITOR_POLARIZED-1411-(3528-MET)
C19, C20: 0.1u 10V X7R; CAPACITOR-0603
IC1, IC2, IC3, IC4, IC5, IC6, IC7, IC8, IC9, IC10, IC11, IC12, IC13, IC14, IC15, IC16, IC17, IC18, IC19, IC20, IC21, IC22, IC23, IC24, IC25: GP2S60
IC26: STM32L151VE; LQFP100_14X14
IC27: TI-LM5165YDRCR; VSON-10-0.5MM
IC28: TI-TPS62170; WSON-8-0.5MM
IC29: AD-REF196GSZ; SOIC-8
IC30: AD-ADP124ARHZ; MSOP-8-EP
J1: MOLEX-502382-02XX
J2: MOLEX-502382-05XX
J3: MOLEX-53261-0771
L1: 3.3u 2.63A; VLS3012HBX
L2: 150u 0.35A; ELL-6SH151M
R1, R2, R5, R6, R9, R10, R13, R14, R17, R18, R21, R22, R25, R26, R29, R30, R33, R34, R37, R38, R41, R42, R45, R47, R49: 1k; RESISTOR-0603
R3, R4, R7, R8, R11, R12, R15, R16, R19, R20, R23, R24, R27, R28, R31, R32, R35, R36, R39, R40, R43, R44, R46, R48, R50: 220k; RESISTOR-0603
R51: 100k; RESISTOR-0603
R52: 121k 1%; RESISTOR-0603
R53: 100k 1%; RESISTOR-0603
R54: 0.5 1%; RESISTOR-0603
R55: 610k 1%; RESISTOR-0603
R56: 180k 1%; RESISTOR-0603
R57, R58, R59, R60, R61, R62, R63, R64, R65: 0; RESISTOR-0603

Connections:
!RST: C6.1, IC26.14, J3.1
BOOT0: IC26.94, R51.P$1
GND: C1.2, C2.2, C3.2, C4.2, C5.2, C6.2, C7.2, C8.2, C9.P$2, C10.2, C11.2, C12.2, C13.2, C14.2, C15.2, C16.2, C17.NEG, C18.2, C19.2, C20.2, IC1.2, IC1.3, IC2.2, IC2.3, IC3.2, IC3.3, IC4.2, IC4.3, IC5.2, IC5.3, IC6.2, IC6.3, IC7.2, IC7.3, IC8.2, IC8.3, IC9.2, IC9.3, IC10.2, IC10.3, IC11.2, IC11.3, IC12.2, IC12.3, IC13.2, IC13.3, IC14.2, IC14.3, IC15.2, IC15.3, IC16.2, IC16.3, IC17.2, IC17.3, IC18.2, IC18.3, IC19.2, IC19.3, IC20.2, IC20.3, IC21.2, IC21.3, IC22.2, IC22.3, IC23.2, IC23.3, IC24.2, IC24.3, IC25.2, IC25.3, IC26.10, IC26.19, IC26.20, IC26.27, IC26.49, IC26.74, IC26.99, IC27.3, IC27.10, IC27.11, IC28.1, IC28.4, IC28.9, IC29.4, IC30.4, IC30.PAD, J1.2, J1.G1, J1.G2, J2.1, J2.G1, J2.G2, J3.7, J3.G1, J3.G2, R51.P$2, R52.P$2, R56.P$1
I2C1_SCL: IC26.92, R60.P$1
I2C1_SDA: IC26.93, R57.P$1
I2C1_SMBA: IC26.91, R64.P$2
IC27_SW: IC27.1, L2.1
IC28_SW: IC28.7, L1.1
unnamed: IC3.4, R5.P$1
unnamed: IC1.4, R1.P$1
unnamed: IC5.4, R9.P$1
unnamed: IC7.4, R13.P$1
unnamed: IC9.4, R17.P$1
unnamed: IC11.4, R21.P$1
unnamed: IC13.4, R25.P$1
unnamed: IC4.4, R6.P$1
unnamed: IC6.4, R10.P$1
unnamed: IC8.4, R14.P$1
unnamed: IC10.4, R18.P$1
unnamed: IC2.4, R2.P$1
unnamed: IC12.4, R22.P$1
unnamed: IC14.4, R26.P$1
unnamed: IC15.4, R29.P$1
unnamed: IC17.4, R33.P$1
unnamed: IC19.4, R37.P$1
unnamed: IC21.4, R41.P$1
unnamed: IC23.4, R45.P$1
unnamed: IC24.4, R47.P$1
unnamed: IC25.4, R49.P$1
unnamed: IC16.4, R30.P$1
unnamed: IC18.4, R34.P$1
unnamed: IC20.4, R38.P$1
unnamed: IC22.4, R42.P$1
unnamed: J2.2, R57.P$2, R58.P$2, R59.P$2
unnamed: J2.3, R60.P$2, R61.P$2, R62.P$2
unnamed: J2.4, R63.P$1, R64.P$1
unnamed: J2.5, R65.P$1
unnamed: IC27.5, R52.P$1
unnamed: C10.1, IC27.4
unnamed: C11.1, R54.P$2
unnamed: IC28.8, R53.P$1
unnamed: IC28.5, R55.P$1, R56.P$2
SENSOR_1: IC1.1, IC26.15, R3.P$1
SENSOR_2: IC3.1, IC26.16, R7.P$1
SENSOR_3: IC5.1, IC26.17, R11.P$1
SENSOR_4: IC7.1, IC26.18, R15.P$1
SENSOR_5: IC9.1, IC26.23, R19.P$1
SENSOR_6: IC11.1, IC26.24, R23.P$1
SENSOR_7: IC13.1, IC26.25, R27.P$1
SENSOR_8: IC4.1, IC26.26, R8.P$1
SENSOR_9: IC6.1, IC26.29, R12.P$1
SENSOR_10: IC8.1, IC26.30, R16.P$1
SENSOR_11: IC10.1, IC26.31, R20.P$1
SENSOR_12: IC2.1, IC26.32, R4.P$1
SENSOR_13: IC12.1, IC26.33, R24.P$1
SENSOR_14: IC14.1, IC26.34, R28.P$1
SENSOR_15: IC15.1, IC26.35, R31.P$1
SENSOR_16: IC17.1, IC26.36, R35.P$1
SENSOR_17: IC19.1, IC26.37, R39.P$1
SENSOR_18: IC21.1, IC26.38, R43.P$1
SENSOR_19: IC23.1, IC26.39, R46.P$1
SENSOR_20: IC24.1, IC26.40, R48.P$1
SENSOR_21: IC25.1, IC26.41, R50.P$1
SENSOR_22: IC16.1, IC26.51, R32.P$1
SENSOR_23: IC18.1, IC26.52, R36.P$1
SENSOR_24: IC20.1, IC26.53, R40.P$1
SENSOR_25: IC22.1, IC26.54, R44.P$1
SPI3_MISO: IC26.79, R62.P$1
SPI3_MOSI: IC26.80, R59.P$1
SPI3_NSS: IC26.77, R65.P$2
SPI3_SCK: IC26.78, R63.P$2
STLINK_SWO: IC26.89, J3.5
STLINK_TCK: IC26.76, J3.6
STLINK_TMS: IC26.72, J3.4
STLINK_USART1_RX: IC26.69, J3.3
STLINK_USART1_TX: IC26.68, J3.2
USART2_RX: IC26.87, R58.P$1
USART2_TX: IC26.86, R61.P$1
VBAT: C8.1, C9.P$1, C14.1, C16.1, IC27.2, IC27.7, IC28.2, IC28.3, IC29.2, IC29.3, J1.1
VDD: C1.1, C2.1, C3.1, C4.1, C5.1, C7.1, C12.1, IC26.6, IC26.11, IC26.28, IC26.50, IC26.75, IC26.100, IC27.8, L2.2, R54.P$1
VDDA: C18.1, C20.1, IC26.22, IC30.1, IC30.2, IC30.3, R1.P$2, R2.P$2, R3.P$2, R4.P$2, R5.P$2, R6.P$2, R7.P$2, R8.P$2, R9.P$2, R10.P$2, R11.P$2, R12.P$2, R13.P$2, R14.P$2, R15.P$2, R16.P$2, R17.P$2, R18.P$2, R19.P$2, R20.P$2, R21.P$2, R22.P$2, R23.P$2, R24.P$2, R25.P$2, R26.P$2, R27.P$2, R28.P$2, R29.P$2, R30.P$2, R31.P$2, R32.P$2, R33.P$2, R34.P$2, R35.P$2, R36.P$2, R37.P$2, R38.P$2, R39.P$2, R40.P$2, R41.P$2, R42.P$2, R43.P$2, R44.P$2, R45.P$2, R46.P$2, R47.P$2, R48.P$2, R49.P$2, R50.P$2
VDDA3.5: C13.1, C15.1, IC28.6, IC30.5, IC30.7, IC30.8, L1.2, R53.P$2, R55.P$2
VREF3.3: C17.POS, C19.1, IC26.21, IC29.6
