robot-corral/mazebot/software/line-sensor-wireless-interface/src-mcu-config/src-mcu-config.ioc

Mcu.UserName=STM32WB55RGVx
PA11.Signal=USB_DM
PA12.Signal=USB_DP
PA13.GPIO_Label=JTMS
PA13.Signal=SYS_JTMS-SWDIO
PA14.GPIO_Label=JTCK
PA14.Signal=SYS_JTCK-SWCLK
PB0.GPIO_Label=LD2 [Green Led]
PB0.Signal=GPIO_Output
PB1.GPIO_Label=LD3 [Red Led]
PB1.Signal=GPIO_Output
PB12.Signal=SPI2_NSS
PB13.Signal=SPI2_SCK
PB3.GPIO_Label=JTDO
PB3.Signal=SYS_JTDO-SWO
PB5.GPIO_Label=LD1 [Blue Led]
PB5.Signal=GPIO_Output
PB6.GPIO_Label=STLINK_RX
PB6.Signal=USART1_TX
PB7.GPIO_Label=STLINK_TX
PB7.Signal=USART1_RX
PC1.Signal=SPI2_MOSI
PC13.Signal=SYS_WKUP2
PC14-OSC32_IN.Signal=RCC_OSC32_IN
PC15-OSC32_OUT.Signal=RCC_OSC32_OUT
PC2.Signal=SPI2_MISO
PC3.GPIO_Label=Line_Sensor_Power
PC3.Signal=GPIO_Output
PC4.GPIO_Label=B1 [Push Button]
PC4.Signal=GPIO_Input
PC5.GPIO_Label=Line_Sensor_Wakeup
PC5.Signal=GPIO_Output
PD0.GPIO_Label=B2 [Push Button]
PD0.Signal=GPIO_Input
PD1.GPIO_Label=B3 [Push Button]
PD1.Signal=GPIO_Input
