robot-corral/mazebot/software/sensors-and-motors/lib-driver-stm32l496ze/src/motor_impl.h

/*******************************************************************************
 * Copyright (C) 2018 Pavel Krupets                                            *
 *******************************************************************************/

#pragma once

void initializeMotor();
