robot-corral/mazebot/software/position-controller/src/global_data_timer.c

#include "global_data_timer.h"

const uint32_t g_dmaTimerDataIncreasing[(DMA_TIMER_STEPS_COUNT + 1) * 3] = {
    399696,
    0,
    199848,
    398790,
    0,
    199395,
    397290,
    0,
    198645,
    395209,
    0,
    197604,
    392566,
    0,
    196283,
    389383,
    0,
    194691,
    385689,
    0,
    192844,
    381513,
    0,
    190756,
    376890,
    0,
    188445,
    371856,
    0,
    185928,
    366447,
    0,
    183223,
    360704,
    0,
    180352,
    354664,
    0,
    177332,
    348367,
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
};

const uint32_t g_dmaTimerDataDecreasing[(DMA_TIMER_STEPS_COUNT + 1) * 3] = {
    26927,
    0,
    13463,
    27193,
    0,
    13596,
    27465,
    0,
    13732,
    27742,
    0,
    13871,
    28025,
    0,
    14012,
    28314,
    0,
    14157,
    28608,
    0,
    14304,
    28908,
    0,
    14454,
    29214,
    0,
    14607,
    29527,
    0,
    14763,
    29846,
    0,
    14923,
    30171,
    0,
    15085,
    30504,
    0,
    15252,
    30843,
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
};

// start time = 0.5005830874732052
