robot-corral/mazebot/software/position-controller/src/led.c

#include "led.h"

#include <stm32\stm32l4xx_ll_gpio.h>

void setPositionControllerMovingLedEnabled(bool isEnabled)
{
    if (isEnabled)
    {
        LL_GPIO_SetOutputPin(GPIOC, LL_GPIO_PIN_7);
    }
    else
    {
        LL_GPIO_ResetOutputPin(GPIOC, LL_GPIO_PIN_7);
    }
}

void setFatalErrorLedEnabled(bool isEnabled)
{
    if (isEnabled)
    {
        LL_GPIO_SetOutputPin(GPIOB, LL_GPIO_PIN_7);
    }
    else
    {
        LL_GPIO_ResetOutputPin(GPIOB, LL_GPIO_PIN_7);
    }
}

void setEmergencyStopLedEnabled(bool isEnabled)
{
    if (isEnabled)
    {
        LL_GPIO_SetOutputPin(GPIOB, LL_GPIO_PIN_14);
    }
    else
    {
        LL_GPIO_ResetOutputPin(GPIOB, LL_GPIO_PIN_14);
    }
}
