robot-corral/mazebot/software/line-sensor/src/dma.c

/*******************************************************************************
 * Copyright (C) 2018 Pavel Krupets                                            *
 *******************************************************************************/

#include "dma.h"

#include "global_data.h"
#include "interrupt_priorities.h"

#include <stm32/stm32l1xx_ll_adc.h>
#include <stm32/stm32l1xx_ll_dma.h>
#include <stm32/stm32l1xx_ll_spi.h>

static void initializeAdc1Dma();
static void initializeSpi2Dma();

void initializeDma()
{
    initializeAdc1Dma();
    initializeSpi2Dma();
}

void initializeAdc1Dma()
{
    NVIC_SetPriority(DMA1_Channel1_IRQn, INTERRUPT_PRIORITY_ADC1);
    NVIC_EnableIRQ(DMA1_Channel1_IRQn);

    LL_DMA_ConfigTransfer(DMA1, LL_DMA_CHANNEL_1, LL_DMA_DIRECTION_PERIPH_TO_MEMORY |
                                                  LL_DMA_MODE_CIRCULAR              |
                                                  LL_DMA_PERIPH_NOINCREMENT         |
                                                  LL_DMA_MEMORY_INCREMENT           |
                                                  LL_DMA_PDATAALIGN_HALFWORD        |
                                                  LL_DMA_MDATAALIGN_HALFWORD        |
                                                  LL_DMA_PRIORITY_HIGH);

    LL_DMA_EnableIT_TC(DMA1, LL_DMA_CHANNEL_1);
    LL_DMA_EnableIT_TE(DMA1, LL_DMA_CHANNEL_1);
}

void initializeSpi2Dma()
{
    NVIC_SetPriority(DMA1_Channel5_IRQn, INTERRUPT_PRIORITY_SPI2_DMA_TRANSMIT);
    NVIC_EnableIRQ(DMA1_Channel5_IRQn);

    // TX

    LL_DMA_ConfigTransfer(DMA1,
                          LL_DMA_CHANNEL_5,
                          LL_DMA_DIRECTION_MEMORY_TO_PERIPH |
                          LL_DMA_PRIORITY_HIGH              |
                          LL_DMA_MODE_NORMAL                |
                          LL_DMA_PERIPH_NOINCREMENT         |
                          LL_DMA_MEMORY_INCREMENT           |
                          LL_DMA_PDATAALIGN_HALFWORD        |
                          LL_DMA_MDATAALIGN_HALFWORD);

    LL_DMA_EnableIT_TC(DMA1, LL_DMA_CHANNEL_5);
    LL_DMA_EnableIT_TE(DMA1, LL_DMA_CHANNEL_5);
}
