robot-corral/mazebot/software/line-sensor/src/interrupt_priorities.h

/*******************************************************************************
 * Copyright (C) 2019 Pavel Krupets                                            *
 *******************************************************************************/

#pragma once

#define INTERRUPT_PRIORITY_SPI2_INTERRUPT    0
#define INTERRUPT_PRIORITY_SPI2_DMA_TRANSMIT 1
#define INTERRUPT_PRIORITY_SPI2_EXTI         2
#define INTERRUPT_PRIORITY_ADC1              3
