robot-corral/mazebot/software/line-sensor/src/watchdog.h

/*******************************************************************************
 * Copyright (C) 2019 Pavel Krupets                                            *
 *******************************************************************************/

#pragma once

void initializeAndStartWatchdog();

void resetWatchdog();
