robot-corral/mazebot/software/line-sensor/src/dma.h

/*******************************************************************************
 * Copyright (C) 2018 Pavel Krupets                                            *
 *******************************************************************************/

#pragma once

#define LL_USART2_DMA_CHANNEL_RX LL_DMA_CHANNEL_6
#define LL_USART2_DMA_CHANNEL_TX LL_DMA_CHANNEL_7

void initializeDma();
