robot-corral/mazebot/software/common/lib-utils/src-test/main.c

/*******************************************************************************
 * Copyright (C) 2018 Pavel Krupets                                            *
 *******************************************************************************/

#include <stdio.h>

#include <test.h>

#include "rolling_values_test.h"

int main()
{
    initializeHardware();

    test_calculateRolling16BitValueDifference();

    for (;;) ;
}
