robot-corral/mazebot/(commit log)

2018-10-10 added line sensor and sensor&control boards
    [line-sensor.brd, line-sensor.sch, sensors-and-control.brd, sensors-and-control.sch]
2018-10-31 fixed flush button to use unused EXTI pin
    [sensors-and-control.brd, sensors-and-control.sch]
2018-11-02 added software for sensors and motors board (initial commit)
    [resources.xlsx]
2018-11-02 added all PCB boards and their revisions (only manufactured and work in progress)
    [line-sensor-rev-1.0-2018-10-02.brd, line-sensor-rev-1.0-2018-10-02.sch, power-breakout-rev-1.0-2018-11-01.brd, power-breakout-rev-1.0-2018-11-01.sch, power-breakout.brd, power-breakout.sch, sensors-and-control-r2.brd, sensors-and-control-r2.sch]
2018-11-15 - added a bit of SPI initialization code - moved SD flush to A12 with it's own EXTI - added 2nd revision board (see revision-history.txt for details)
    [resources.xlsx, sensors-and-control-r2.brd, sensors-and-control-r2.sch]
2018-11-16 - added clock (microsecond resolution) - added imu code (complete) - renamed devices source files to reflect device they implement - added DMA error
    [global_data.c, global_data.h, gpio.h, spi.c, spi.h, status.c, system_clock.c]
2018-11-16 - added line sensor adc code - fixed SPI DMA IRQ handlers to check all flags in one call (as multiple flags can be set)
    [resources.xlsx]
2018-11-16 - added async tasks framework - migrated IMU/LineSensor to use task framework (return sampling frequency, still need to calculate actual values)
    [resources.xlsx]
2018-11-16 - added code to meazure timing of interrupts, etc. - added code to call IMU/LineSensor start query - added MIN function - SPI now remembers which pin it needs to disable on completion
    [resources.xlsx]
2018-11-17 - got rid of individual interrupt frequencies as 2 processes querying data simultaneously affect each other performance
2018-11-17 - line sensor driver will now calculate displacement (as ADC is quite fast and it is implementation specific) - added status LED code for calibrating/running/paused - added code to compute yaw delta 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
    [resources.xlsx]
2018-11-18 - renamed stm32 project to stm32l4
2018-11-18 - reverted to using uint16_t for line sensor min/max
    [global_data.c, global_data.h]
2018-11-27 - created line-sensor rev 2.0 - renamed schematic files to use similar conention
    [line-sensor-r1.brd, line-sensor-r1.sch, line-sensor-r2.brd, line-sensor-r2.sch, power-breakout-r1.brd, power-breakout-r1.sch, sensors-and-control-r1.brd, sensors-and-control-r1.sch]
2018-11-27 - moved lib-stm32l4 and lib-test to common library folder
2018-11-27 - fixed some DRC errors
    [line-sensor-r2.brd]
2018-12-04 - added MATLAB code to find sensor model parameters (will be used to get y position based on sensor reading). Model accepts data set captured by sensors moving multiple times across the line and prod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
2018-12-04 - final parabolas will use max peak instead of mean - fixed bug with min/max values on files where last sensor data is encountered 1st
2018-12-05 - added code to estimate y position of the sensor given sensor reading data
2018-12-05 - added main script which creates and tests line sensor model - added calibration data for the current sensor - added test run data to be used during estimation
    [capture-manual-0-degrees-1.csv, capture-manual-0-degrees-2.csv, capture-manual-0-degrees-reverse-1.csv, capture-manual-0-degrees-reverse-2.csv, robot-run-1.csv]
2018-12-05 - frxed gpio pins initialization bugs
    [gpio.c]
2018-12-06 - added SD card detection PIN (D1) - added pullup resistors for SD's D0-D3 and CMD lines (47k)
    [sensors-and-control-r2.brd, sensors-and-control-r2.sch]
2018-12-07 - added SDMMC headers for STM32L4 - added SD resources to resources map - added code to power up and detect SD card type (SDHC or SDSC) - lowered task timer priority
    [resources.xlsx]
2018-12-07 - moved SD_FLUSH to A8
    [sensors-and-control-r2.brd, sensors-and-control-r2.sch]
2018-12-12 - added sd read blocks function (working) - moved all SD related state into 1 structure (should do similar for other devices) - fixed resources.xlsx file to properly show rev 1.1 resource usage (DMAs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
    [resources.xlsx]
2019-01-11 - added 1st draft of line sensor documentation
2019-01-12 - fixed line model to apply filter before normalization and figuring out min/max values - added more line sensor documentation
2019-01-14 - fixed cut off value to be half distance between min and max in line sensor MATLAB model
2019-01-15 fixed some and added a bit more documentation for line sensor
2019-01-16 - added missing sensor unit groups (all white and all black)
2019-01-24 - added STM32L1 sdk project
2019-01-25 - added line sensor project (for now it is a test concept to check what can be done with 32MHz chip and 40 sensors) - fixed project structure for stm32l4 sdk
    [adc.c, adc.h, dma.c, dma.h, global_data.c, global_data.h, gpio.c, gpio.h]
2019-01-25 - added timing pin - fixed GPIOD configuration - added querying of 2nd part of ADC sensors - move to USART3 instead of 2 (as my board has 3 exposed not 2)
    [adc.c, gpio.c, gpio.h, system_clocks.c]
2019-01-26 - fixed det-os project files - added stub example
    [main.c]
2019-01-26 - fixed lib-stm32l4 project filters
2019-01-26 - added some missing files to stm32l1 and l4 projects - fixed clocks configuration in line sensor - added code to test usart3
    [dma.c, global_data.c, global_data.h, gpio.c, main.c, system_clocks.c]
2019-01-27 - moved usart code to usart.c and fixed interrupt flag clearing - aded code to receive and process command of varying size using usart DMA
    [dma.c]
2019-02-01 - added missing copyright statements
    [adc.c, adc.h, dma.c, dma.h, global_data.c, global_data.h]
2019-02-06 - upgraded to new stm32 packages in visual gdb projects
2019-02-09 - moved timer callback to ASM - fixed svc_handler to properly work if I use main or process stack - added branching to svc_handler (for different svc #imm parameters) - renamed MAX_NUMBER_OF_IDLE_TAS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
    [global_data.c, global_data.h]
2019-02-09 - added ignore for TLA+ toolbox files - reduced stack usage of scheduleTask and SVC_Handler functions - added code to return values from scheduleNextTaskSvc to executeTask so new task can start execu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
2019-02-11 - changed the way 1st task is started to avoid race conditions
    [global_data.c, global_data.h]
2019-02-13 - added code to switch tasks on timer interrupt - added usage of macro defined constants instead of numbers in assembler
2019-02-15 - fixed lib-test project structure - fixed bug with error handling in SVC handler
    [main.c]
2019-02-16 - added description for deterministic os flow diagram
2019-02-16 - moved line sensor code to use new STM32 libraries
2019-02-17 - fixed line sensor code - added ADC querying to measure max performance (seems to be ~16 kHz which is more than enough as target one is 1.6 kHz)
    [adc.c, adc.h, buffer_index.h, dma.c, dma.h, global_data.c, global_data.h, gpio.c]
2019-02-17 added line sensor commands / response documentation
2019-02-21 - added voltage sources for line sensor (not complete)
    [line-sensor-r2.brd, line-sensor-r2.sch]
2019-02-21 - added line sensor power test board schematic
    [power-test-linear.brd, power-test-linear.sch]
2019-02-25 - added line sensor power layout and mcu pin usage configuration
    [line-sensor-r2.brd, line-sensor-r2.sch]
2019-02-26 - finished line sensor with linear regulator and voltage reference
    [line-sensor-r2.brd, line-sensor-r2.sch]
2019-02-26 - finished layout for line sensor with both linear and simple voltage sources (for testing)
    [line-sensor-r2-linear.brd, line-sensor-r2-linear.sch, line-sensor-r2-simple.brd, line-sensor-r2-simple.sch]
2019-02-26 - fixed linear line sensor version a bit
    [line-sensor-r2-linear.brd, line-sensor-r2-linear.sch]
2019-02-26 reverted 70d3239446cd16c9a51eaae359c7199bf8d22def commit as it is somehow incompatible with oshpark
    [line-sensor-r2-linear.brd, line-sensor-r2-linear.sch]
2019-02-27 - decided not to do separate voltage test board as noise from mcu and digital communication lines is hard to emulate and savings aren't that great (board costs quite a bit) - redesigning line sensor 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
    [line-sensor-r2-simple.brd, line-sensor-r2-simple.sch, power-test-linear.brd, power-test-linear.sch, sensor-output-voltage-and-current-consumption.csv]
2019-03-02 - added more data for line sensor modelling, added a bit more documentation for line sensor
    [output_voltage_dependence_on_r1.csv, sensor-output-voltage-and-current-consumption.csv]
2019-03-02 - renamed r2 board to variant 1b to comply with documentation
    [line-sensor-r2-var1b.brd, line-sensor-r2-var1b.sch]
2019-03-04 - added variant 1a line sensor board
    [line-sensor-r2-var1a.brd, line-sensor-r2-var1a.sch]
2019-03-04 - small fixed to line sensor documentation - migreated more projects to latest STM32 library - small fixes to line sensor error code
    [line_sensor_defs.h]
2019-03-06 - added var1a versions which were ordered for manufacturing
    [line-sensor-r2-var1a-2019-03-04.brd, line-sensor-r2-var1a-2019-03-04.sch]
2019-03-07 - added data to determine R1 and R2 resistor tolerance in line sensor (both should have %1)
    [output-voltage-dependence-on-r1-r2-tolerance-vin3.5.csv, output-voltage-dependence-on-r1.csv]
2019-03-07 - starting to use TLA for proof of algorithms - fixed line sensor R2 VAR1B schematic a bit (needs a lot more work, after I pick resistor values and voltage ranges) - minor fixes in documentation - mi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
    [line-sensor-r2-var1b.brd, line-sensor-r2-var1b.sch]
2019-03-07 - fixing motors and sensors controller projects
    [resources.xlsx]
2019-03-07 - fixed lib-utils tests structure
    [main.c, rolling_values_test.c, rolling_values_test.h]
2019-03-07 - added test data for multiple sensor units for R1=1.5k and R2=220k
    [sensor-output-voltage-and-current-consumption-r1-1.0k-r2-220k-h-2mm.csv, sensor-output-voltage-and-current-consumption-r1-1.5k-r2-220k-h-2mm.csv]
2019-03-08 - added remaining data to test how R1 value affects output voltage in case multiple sensors are working
    [sensor-output-voltage-and-current-consumption-r1-1.0k-r2-220k-h-2mm.csv, sensor-output-voltage-and-current-consumption-r1-1.0k-r2-220k-h-4mm.csv, sensor-output-voltage-and-current-consumption-r1-1.2k-r2-220k-h-2mm.csv, sensor-output-voltage-and-current-consumption-r1-1.2k-r2-220k-h-4mm.csv, sensor-output-voltage-and-current-consumption-r1-1.5k-r2-220k-h-2mm.csv, sensor-output-voltage-and-current-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]
2019-03-09 - added output voltage reading for R1 = 2.2k - improved line sensor documentation a bit (selection of R1/Vin)
    [sensor-output-voltage-and-current-consumption-r1-1.0k-r2-220k-h-2mm.csv, sensor-output-voltage-and-current-consumption-r1-1.0k-r2-220k-h-4mm.csv, sensor-output-voltage-and-current-consumption-r1-2.2k-r2-220k-h-2mm.csv, sensor-output-voltage-and-current-consumption-r1-2.2k-r2-220k-h-4mm.csv]
2019-03-09 - added R1=2.7k data just in case
    [sensor-output-voltage-and-current-consumption-r1-2.7k-r2-220k-h-2mm.csv, sensor-output-voltage-and-current-consumption-r1-2.7k-r2-220k-h-4mm.csv]
2019-03-11 - added VAR1B, VAR2A parameters selection, improved linear voltage schematics description
2019-03-12 - as line sensor var1a hardware is ready moving all its projects to use stm32l151ve chip instead of ze nucleo board
2019-03-13 - by default keep DMA channels disabled in case we later change configuration - removed unused spi / i2c - migrated code to use VE (LQFP100) chip instead of ZE (LQFP144)
2019-03-13 - added VAR1A ADC output data and fixed documentation
    [var1a-all-black-histogram.csv, var1a-all-white-histogram.csv, var1a-thin-black-line-histogram.csv]
2019-03-14 - added timer header to STM31L1 library - fixed ADC accuracy (slowed it down a bit) - fixed some invalid hardcoded array length - added timer with microsecond resolution
    [adc.c, adc.h, global_data.c, system_clocks.c, system_clocks.h]
2019-03-14 - added data not ready status - fixed rcc clocks configs (names are so similar it is easy to mess them up) - set adc channels 3 and 8 to fast speed - no need to initialize GPIOH as its clock is disab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
    [adc.c, gpio.c, line_sensor_defs.h, system_clocks.c]
2019-03-14 - added line sensor buffers, errors and watchdog documentation
2019-03-14 - added watchdog timer and reset if adc wasn't queried successfully in last ((6 * 4) / 37000) = 0.648649 milliseconds
    [adc.c, global_data.c, global_data.h, main.c, watchdog.c, watchdog.h]
2019-03-16 - watch dog is configured and started before anything else - added watch dog and adc error flags - removed unused buffer index code (will be redesigned to comply with new specs) - adc uses constants 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
    [adc.c, buffer_index.h, global_data.c, global_data.h, line_sensor_defs.h, main.c, watchdog.c]
2019-03-16 - added clampU16/convertU16ValueToUQ1_15 to math_utils - added stm32l151ve project for lib-utils - removed uneccesary LL_APB1_GRP1_EnableClock from system_clocks.c - added code to process adc data af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
2019-03-16 - added line sensor test client - dma should be configured prior to devices which use it
2019-03-17 - fixed client usart initialization (figuring out why do I get 255 garbage byte from time to time - adc buffers must be 2 byte aligned - added code to respond to sent sensor data command
    [adc.c, buffer_index.h, dma.c, dma.h, global_data.c, global_data.h, line_sensor_defs.h, main.c]
2019-03-17 - all USART structures are now packed - fixed line sensor response status (added more errors and reorganized it) - added prefix to all commands to detect start of command and command response - fixed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
    [adc.c, global_data.c, global_data.h, line_sensor.h, line_sensor_defs.h, main.c, watchdog.c]
2019-03-18 - renamed var1a files (rev is after var)
    [line-sensor-r2-var1b.brd, line-sensor-r2-var1b.sch, line-sensor-var1a-r2-2019-03-04.brd, line-sensor-var1a-r2-2019-03-04.sch, line-sensor-var1a-r2.brd, line-sensor-var1a-r2.sch]
2019-03-18 - added clock to line sensor test client - reduced pin speed for UART to high (<= 10MHz)
2019-03-18 - migrating motor / sensor control system project to det os (moving stuff around)
    [resources.xlsx]
2019-03-18 - renamed project for motor / sensor controller
2019-03-18 - unified project structure (fixing motor / sensors controller)
2019-03-18 - adding source files to motor / sensor control project
2019-03-18 - added motor / sensor control references
2019-03-18 - motor / sensor controller code is now compiling
2019-03-18 - cleaned up hardware folders
    [line-sensor-var1-r1-2018-10-02.brd, line-sensor-var1-r1-2018-10-02.sch, line-sensor-var1-r1.brd, line-sensor-var1-r1.sch, line-sensor-var1a-r2-2019-03-04.brd, line-sensor-var1a-r2-2019-03-04.sch, line-sensor-var1a-r2.brd, line-sensor-var1a-r2.sch]
2019-03-18 - removing uneccesary code from motor / sensor controller - adding det-os code to run 1st task
2019-03-19 - added code to measure duty cycle of timer task switching task
2019-03-19 - fixed linker issues (ductape) for weak function overrides from assembler
    [main.c]
2019-03-20 - set os timer to 3200 Hz
2019-03-20 - test can now run on stm32l496z# nucleo board
2019-03-21 - fixed error when TIM2_IRQHandler wasn't failing on error (labelError wasn't called) - migrated to use pointers instead of indexes into scheduled tasks list - added index to last task in the group o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
    [global_data.c, global_data.h, main.c]
2019-03-21 - added constant for all det os svc interrupt priorities - removed unused code from det os example - switched to using PendSV interrupt instead of overwriting timer interrupt in os
2019-03-21 - fixed motor / sensor control to use new way we handle task scheduler interrupts - added notes on which interrupt should have DET_OS_SVC_INTERRUT_PRIORITY priority
    [system_clock.c]
2019-03-21 - fixed line sensor commands and response documentation (plus error codes)
2019-03-21 - fixed det-os test project to use new test harness
    [main.c]
2019-04-06 - added current time notion to det-os - added priority comparison macros - added yield functionality implementation
2019-10-03 - fixed delete task not setting parent's next task properly - added 3rd revision of line sensor PCB
    [line-sensor-var1a-r3.brd, line-sensor-var1a-r3.sch]
2019-10-06 finished 3rd revision of line sensor
    [line-sensor-var1a-r3.brd, line-sensor-var1a-r3.sch]
2019-10-06 minor fixes of resistor values, added copies of schematics / board which was ordered from oshpark
    [line-sensor-var1a-r3-2019-10-06.brd, line-sensor-var1a-r3-2019-10-06.sch]
2019-10-08 - upgraded STM32L1 and STM32L4 to use new libraries
2019-10-25 - fixing project for new sensor board
    [dma.c, gpio.c, line_sensor_defs.h, main.c, spi.c, spi.h, system_clocks.c]
2019-10-25 - fixed crystal capacitors - fixed spi2 gpio config - disabled external crystals as capacitors seems to be wrong
    [line-sensor-var1a-r3-2019-10-06.brd, line-sensor-var1a-r3-2019-10-06.sch]
2019-10-27 - added test client SPI code - added partial line sesnor spi code
2019-10-27 - slave spi is now receiving data
2019-10-28 - added new way to handle commands and responses as now we use spi
2019-10-28 - added LL crc binary to STM32L4 and STM32L1
2019-10-28 - added a bit more code for spi communication - added a bit more sensor status code
2019-11-05 - added code for line sensor to receive requests and respond to them (only reset command)
    [adc.c, adc.h, dma.c, global_data.c, global_data.h, global_settings.h, gpio.c, gpio.h]
2019-11-05 - spi is now initialized by setting CR1 / CR2 registers directly instead of making many set calls
2019-11-06 - added remaining SPI commands
2019-11-06 - watchdog will now reset if either ADC or SPI didn't report in
    [line-sensor-var1a-r3.brd, line-sensor-var1a-r3.sch]
2019-11-06 - removed 32.7 kHz crystal - replaced 24 MHz crystal with 8 MHz one - fixed ring around crustal - removed all but ground layers underneath crystal location
    [line-sensor-var1a-r3.brd, line-sensor-var1a-r3.sch]
2019-11-06 - crc calculation is now done inline when SPI is called (for now, need to check how CRC hardware handles interrupts)
2019-11-07 - added code to collect calibration data - added parameter to SPI commands
2019-11-14 - improved test client code a bit - fixed watchdog to only detect adc problems (client can disable / enable line sensor himself if communication isn't possible)
    [adc.c, global_data.c, global_data.h, main.c, spi.c, watchdog.c, watchdog.h]
2019-11-14 - added configuration for ST-Link uart for nucleo board (so I can send command and receive data back)
2019-11-15 - added code to initialize timer to control motor
2019-11-19 - created separate project for controller firmware - added slave timer to count number of ticks on PWM timer to stop motor
2019-11-19 - added notes on when stepper motor moves
2019-11-21 - more or less added motor control code
2019-11-21 - added busy flag to motor control
2019-11-27 - most of the motor control code is done
2019-12-10 - added partial code for limit switches
2019-12-11 - removed line sensor code from position controller (it will go into separate bluetooth board)
2019-12-11 - added calibration procedure
2019-12-11 - fixed status returned by position controller - fixed python script to calibrate position controller and move to the middle after that
    [client_communication_uart.c, client_communication_uart.h, position_controller.c, position_controller.h]
2019-12-11 - added more leds (for uart tx/rx and errors)
    [client_communication_uart.c, gpio.c, led.c, position_controller.c, system_clock.c]
2019-12-13 - added skeleton project for src-line-sensor-wireless - added lib-stm32wb library project
2019-12-13 - line-sensor-wireless now compiles
2019-12-13 - renamed prj-stm32wb project to lib-stm32wb - added a bunch more headers to lib-stm32wb
2019-12-16 - added exti and rtc ll drivers
2019-12-17 - device is discoverable by Bluetooth LE Explorer
2019-12-23 - new version of stm32 libraries
2019-12-29 - added code to discover serial and ble devices in ui - changed ble device name
2019-12-30 - added stm32l476rg library
2019-12-30 - position controller can now work on stm32l476rg and stm32l476rg
2019-12-31 - added code to connect to serial device and verify it - commands are synchronous by default
2020-01-08 #1 - move position-controller into separate project folder as it's not related to line sensor
2020-01-12 #11 - enable line sensor data broadcasting
2020-01-12 - added wireless line sensor hardware configuration
2020-01-13 #16 - decodeCommand doesn't decode negated command and parameter (those are used for duplication) #18 - convert test code to use stm32l476rg chip
    [main.c, spi.c, src-mcu-config.ioc, src-test-client-mcu-config.ioc]
2020-01-17 - fixed SPI communications a bit (filler is now fixed to 32 bits for slow to 2.5 MBits/s speeds) - SPI device will now work on the same bus with other devices (it gets properly started and stopped ba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
    [adc.c, consumer_producer_buffer.h, dma.c, global_data.c, global_data.h, global_settings.h, gpio.c, interrupt_priorities.h]
2020-01-18 #21 - adc should scan sensors at a specified frequency not at max speed (at least until I move to using realtime os for firmware)
2020-01-19 #19 - test board next to BLE wireless board. Need to check interference from BLE and if I need to put capacitors.
    [line_sensor.h]
2020-01-19 #6 - query line sensor
2020-01-19 - moved consumer_producer_buffer.h to common utils - added safe means of accessing address of sensor values
2020-01-20 - fixed pins configuration
    [src-mcu-config.ioc]
2020-01-20 - fixed pins not to use buttons pins
    [gpio.c, line_sensor_client.c, src-mcu-config.ioc]
2020-01-20 - fixed bug where SCK AF wasn't set up properly
    [app_ble.c, line_sensor_client.c]
2020-01-20 #26 - add code to receive BLE data from wireless line sensor
2020-01-26 - added C# Stm32Crc32 utility class - minor fixes
    [client_communication_uart.c, client_communication_uart.h, p2p_server_app.c]
2020-01-29 #12 - add code to disconnect from serial device #35 - add command to emergency stop devices
2020-02-02 #40 - add position controller calibration command #37 - add command to reset position controller #39 - display position controller's current position
2020-02-02 - moved interrupt masking functions into utils - fixed wireless line sensor release build
    [position_controller.c, spi.c]
2020-02-03 #41 - position controller calibration is flaky #42 - fix potential concurrency issues in position controller (timer and limit switches have different interrupt priorities) #43 - add state diagram for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
    [client_communication_uart.c, client_communication_uart.h, global_data.c, global_data.h, position_controller.c, position_controller.h]
2020-02-03 - small position controller fixes
    [client_communication_uart.h, position_controller.c]
2020-02-03 - fixed get status command
    [client_communication_uart.c]
2020-02-03 - fixed emergency stop result status reporting
    [client_communication_uart.c]
2020-02-03 - updated line sensor data collector to use updated position controller logic
2020-02-03 - fixed some more bugs in position controller
    [position_controller.c]
2020-02-04 - fixed more bugs, calibration seems to be functioning fine now
    [position_controller.c]
2020-02-04 #36 - add command to rescan devices #25 - add code to stop / start BLE device scanning #14 - add code to disconnect devices when app is closed / suspended /etc. #13 - add code to disconnect from BLE 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
2020-03-06 #48 - from time to time position controller stops responding to any commands sent by the client - updated STM32WB library to v1.5
2020-03-06 #28 - display and save to a file position and wireless line sensor output #46 - add step size editor for data collection #47 - add editor to enter number of line sensor value collection iterations
2020-03-06 - stm32l4 v1.15.1
2020-03-07 - removed STM32L476RG code from position controller
2020-03-07 - added configuration for DMA frequency ramp-up (#51 - need to speed up and slow down stepper gradually instead of doing it at max speed all the time)
2020-03-09 #51 - need to speed up and slow down stepper gradually instead of doing it at max speed all the time
2020-03-10 - minor fixes to position controller
    [position_controller.c]
2020-03-11 - removed old projects - fixed minor issues in line sensor pcb
    [line-sensor-var1-r1-2018-10-02.brd, line-sensor-var1-r1-2018-10-02.sch, line-sensor-var1-r1.brd, line-sensor-var1-r1.sch, line-sensor-var1a-r2-2019-03-04.brd, line-sensor-var1a-r2-2019-03-04.sch, line-sensor-var1a-r2.brd, line-sensor-var1a-r2.sch]
2020-03-17 #63 - startSlowingDown_Atomic for some reason needs to add 2 instead of 1 extra data items in DMA
2020-03-17 - added motor signal generation docs (for future reference)
